bibibi0201/FinalProject/Report/รูปอุปกรณ์/esp32.jpg

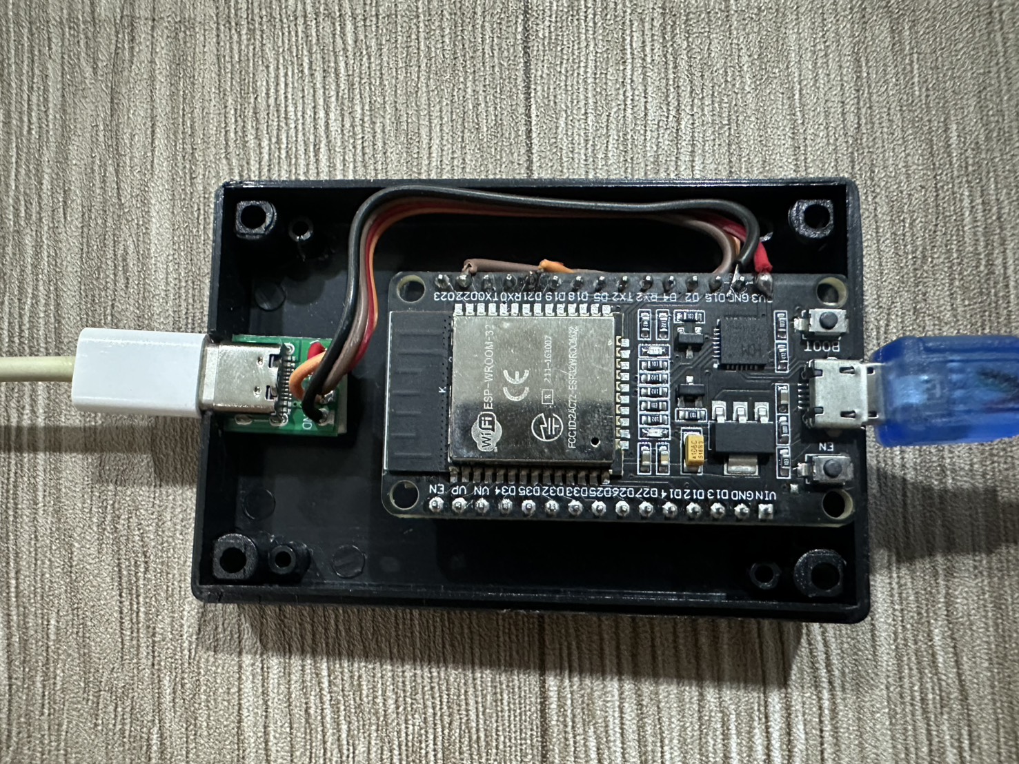
Report/รูปอุปกรณ์/esp32.jpg
