bibibi0201/FinalProject/Report/รูปอุปกรณ์/mpu6050.jpg

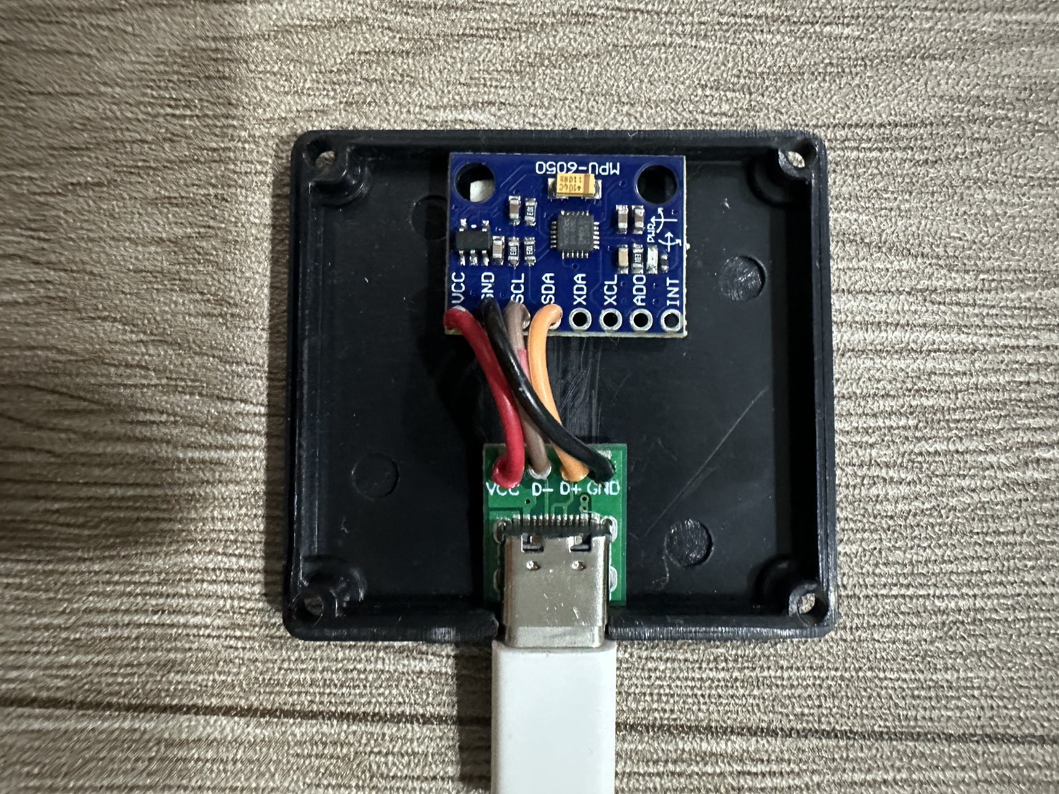
Report/รูปอุปกรณ์/mpu6050.jpg
