bibibi0201/FinalProject/Report/CDIO/แบบรายงานทางเทคนิค_CDIO_ESE-SS-68-02.pdf

## ต้นแบบระบบแจ้งเตือนท่านั่งที่ผิดปกติสําหรับผู้ทํางานออฟฟิศ

A Prototype of an Abnormal Posture Alert System for Office Workers

นางสาวชยาภรณ์ ลิ้มทัศไนยกุล | รหัสนิสิต 65050089
นางสาวกชามาส ขันทะศิลา | รหัสนิสิต 65050096
นายสุทธิอัต | เบ็ญเจิด | รหัสนิสิต 65050247

รายงานสรุปโครงงานฉบับนี้เป็นส่วนหนึ่งของการศึกษาตามหลักสูตรวิศวกรรมศาสตร์บัณฑิต สาขาวิชาวิศวกรรมระบบสมองกลฝังตัวและอิเล็กทรอนิกส์สื่อสาร ภาควิชาวิศวกรรมไฟฟ้า คณะวิศวกรรมศาสตร์ มหาวิทยาลัยบูรพา
ปีการศึกษา 2568

A Prototype of an Abnormal Posture Alert System for Office Workers

Chayaphorn Limtassanaiyakul | Student ID 65050089
Kachamas | Khuntasila | Student ID 65050096
Sutthiut | Benjerd | Student ID 65050247

A PROJECT SUMMARYREPORT SUBMITTED IN PARTIAL FULFILLMENT OF THEREQUIREMENTSFOR THE DEGREE OFBACHELOR OF ENGINEERING EMBEDDED SYSTEM AND ELECTRONIC COMMUNICATION ENGINEERING DEPARTMENT OF ELECTRICALENGINEERING BURAPHA UNIVERSITY2025

ชื่อโครงงาน ต้นแบบระบบแจ้งเตือนท่านั่งที่ผิดปกติสําหรับผู้ทํางานออฟฟิศ
โดย | นางสาวชยาภรณ์ลิ้มทัศไนยกุล รหัสนิสิต 65050089
นางสาวกชามาส ขันทะศิลา | รหัสนิสิต 65050096
นายสุทธิอัต เบ็ญเจิด | รหัสนิสิต 65050247
อาจารย์ที่ปรึกษาดร. สมเจต ศุภรังสรรค์
จํานวนหน้า 15 หน้า
ปีการศึกษา 2568

ภาควิชาวิศวกรรมไฟฟ้า คณะวิศวกรรมศาสตร์มหาวิทยาลัยบูรพา อนุมัติรายงานสรุปโครงงานฉบับนี้เป็นส่วนหนึ่งของการศึกษาตามหลักสูตรปริญญาวิศวกรรมศาสตร บัณฑิต สาขาวิชาวิศวกรรมระบบสมองกลฝังตัวและอิเล็กทรอนิกส์สื่อสาร

| อาจารย์ที่ปรึกษา
(ดร. สมเจต ศุภรังสรรค์)
| หัวหน้าภาควิชาวิศวกรรมไฟฟ้า
(ดร.ณัฐพันธ์ถนอมสัตย์)

รายงานทางเทคนิค (Technical Report) ส่วนที่ 1 รายละเอียดโครงงาน
ชื่อโครงงาน ต้นแบบระบบแจ้งเตือนท่านั่งที่ผิดปกติสําหรับผู้ทํางานออฟฟิศ สาขาวิชา วิศวกรรมระบบสมองกลฝังตัวและอิเล็กทรอนิกส์สื่อสาร วิเคราะห์และกําหนดประเด็นปัญหา (C)

### 1. ที่มาและความสําคัญของปัญหา

ในปัจจุบัน พนักงานออฟฟิศและนักศึกษาจํานวนมากต้องนั่งทํางานหน้าคอมพิวเตอร์เป็น เวลานานต่อเนื่องกันหลายชั่วโมงต่อวัน พฤติกรรมดังกล่าวส่งผลให้เกิดท่านั่งที่ไม่เหมาะสมโดยไม่รู้ตัว เช่น การนั่งหลังค่อม การเอียงลําตัวไปด้านใดด้านหนึ่ง หรือการคงท่าเดิมเป็นเวลานาน ซึ่งล้วนเป็น ความเสี่ยงที่ก่อให้เกิดอาการปวดหลัง ปวดคอ ปวดไหล่และภาวะออฟฟิศซินโดรมในระยะยาว แม้จะมีอุปกรณ์ด้านการยศาสตร์(Ergonomics) เช่น เก้าอี้เพื่อสุขภาพ หรืออุปกรณ์รองรับ แผ่นหลัง แต่ผู้ใช้งานยังไม่สามารถประเมินท่านั่งของตนเองได้แบบเรียลไทม์และไม่ทราบว่าเมื่อใด ที่ท่านั่งเริ่มเบี่ยงเบนจากท่าปกติยิ่งไปกว่านั้นท่าทางและสรีระของแต่ละบุคคลมีความแตกต่างกัน ทําให้ไม่สามารถกําหนดค่ามาตรฐานมุมการนั่งแบบเดียวกันสําหรับทุกคนได้การออกแบบระบบ ที่สามารถปรับเทียบค่ามาตรฐานเฉพาะบุคคล (Personal Calibration) จึงมีความสําคัญ เพื ่อให้ การประเมินท่านั่งมีความแม่นยําและเหมาะสมกับผู้ใช้แต่ละราย
จากปัญหาที่กล่าวมาข้างต้น จึงนํามาสู่แนวคิดในการพัฒนาต้นแบบอุปกรณ์สวมใส่บริเวณ แผ่นหลังตรวจจับท่านั่งที่ผิดร่วมกับแอปพลิเคชันแจ้งเตือนท่านั่ง โดยติดตั้งเซนเซอร์ตรวจวัดเชิงมุม บริเวณกระดูกสันส่วนบน (Thoracic Spine) เพื่อวัดการก้ม – เงยและการเอียงของลําตัวส่วนบน จากนั้นนําข้อมูลที ่ได้ไปเปรียบเทียบกับค ่ามาตรฐานเฉพาะบุคคลที ่ได้จากการปรับเทียบเริ ่มต้น หากพบว่าท่านั่งเบี่ยงเบนเกินช่วงที่กําหนด ระบบจะแจ้งเตือนผู้ใช้งานทันทีผ ่านแอปพลิเคชัน ซึ่งช่วยให้สามารถปรับพฤติกรรมการนั่งให้เหมาะสม และลดความเสี่ยงต่อปัญหาสุขภาพในระยะยาว

### 2. กลุ่มผู้ใช้งาน

พนักงานออฟฟิศทั่วไปหรือผู้ที่ต้องนั่งทํางานหน้าคอมพิวเตอร์เป็นเวลานาน

### 3. กระบวนการได้มาซึ่งรายละเอียดและความต้องการทางวิศวกรรม

การกําหนดรายละเอียดและความต้องการของระบบเกิดจากการศึกษาปัญหาทางด้าน การยศาสตร์งานวิจัยที่เกี่ยวข้องกับการตรวจจับท่านั่ง รวมถึงการวิเคราะห์พฤติกรรมของผู้ใช้งาน ที่ต้องนั่งทํางานเป็นเวลานาน จากการศึกษาพบว ่าระบบที ่มีประสิทธิภาพควรสามารถตรวจจับ การก้ม–เงยและการเอียงลําตัวได้แบบต่อเนื่อง และแจ้งเตือนเมื่อท่านั่งเบี่ยงเบนเกินช่วงที่เหมาะสม นอกจากนี้ยังพบว่าท่าทางและสรีระของแต่ละบุคคลมีความแตกต่างกันจึงกําหนดให้ระบบ ต้องมีขั้นตอนการปรับเทียบค่าเริ่มต้น เพื่อกําหนดค่ามาตรฐานเฉพาะบุคคลก่อนเริ่มใช้งาน

2

จากการวิเคราะห์ดังกล่าว จึงสรุปความต้องการทางวิศวกรรมของระบบได้ดังนี้
1. ระบบต้องสามารถวัดมุมการก้ม–เงย (Pitch) และการเอียงซ้าย–ขวา (Roll) ของ ลําตัวส่วนบนได้อย่างต่อเนื่อง
2. ระบบต้องรองรับการปรับเทียบค่าอ้างอิงเฉพาะบุคคล
3. ระบบต้องสามารถแจ้งเตือนแบบเรียลไทม์เมื่อท่านั่งผิดปกติ
4. ระบบต้องสามารถบันทึกข้อมูลเพื่อวิเคราะห์พฤติกรรมย้อนหลังได้ ลักษณะและความมุ่งหมายของการออกแบบ (C)

### 1. วัตถุประสงค์

1. เพื่อพัฒนาต้นแบบอุปกรณ์สวมใส่ติดแผ่นหลังตรวจจับท่านั่งที่ผิดและแอปพลิเคชัน แจ้งเตือนท่านั่งสําหรับผู้ทํางานออฟฟิศ
2. เพื่อสร้างระบบแสดงผลข้อมูลและระบบแจ้งเตือนท่านั่งที่ไม่เหมาะสมแบบเรียลไทม์
3. เพื่อพัฒนาระบบให้คําแนะนําการปรับท่านั่งและท่ายืดที่เหมาะสม
4. เพื่อจัดเก็บข้อมูลพฤติกรรมการนั่งสําหรับการวิเคราะห์ย้อนหลังและปรับปรุง พฤติกรรมในระยะยาว

### 2. ลักษณะเฉพาะที่ได้คิดค้นขึ้นหรือขอบเขตในการออกแบบ

โครงงานนี้พัฒนาต้นแบบอุปกรณ์สวมใส่ติดแผ่นหลังตรวจจับท่านั่งที่ผิด ที่ติดตั้งเซนเซอร์ ตรวจวัดเชิงมุมเพียง 1 จุดบริเวณกระดูกสันหลังส่วนบน เพื่อใช้ประเมินการก้ม–เงย และการเอียงลําตัวด้านข้าง ในท่านั่งทํางาน โดยเลือกตําแหน่งดังกล่าวเพื่อให้สะท้อนการเปลี่ยนแปลง ของท่าทางช่วงอกตอนบนได้อย่างชัดเจน พร้อมทั้งลดความซับซ้อนและต้นทุนของระบบเมื่อเทียบกับ การใช้หลายเซนเซอร์
ระบบออกแบบให้มีขั้นตอน Calibration สําหรับกําหนดค่าท่าปกติของผู้ใช้แต่ละราย และใช้ค่าความเบี่ยงเบนเชิงมุมจากตําแหน่งอ้างอิงเป็นเกณฑ์ในการประเมินความผิดปกติของท่านั่ง ซึ่งช่วยเพิ่มความเหมาะสมกับสรีระที่แตกต่างกันของผู้ใช้งาน การประมวลผลทําแบบเรียลไทม์เมื่อค่ามุมเกินช่วงที่กําหนด ระบบจะส่งสัญญาณแจ้งเตือน ผ่านแอปพลิเคชัน และบันทึกข้อมูลเพื่อใช้วิเคราะห์แนวโน้มพฤติกรรมการนั่งในระยะยาว

### 3. ขอบเขตการออกแบบ

มุ่งเน้นการตรวจจับท่านั่งในบริบทการทํางานกับโต๊ะหรือคอมพิวเตอร์และเป็นต้นแบบเชิง วิศวกรรมเพื่อการศึกษา

3

การออกแบบทางวิศวกรรม (D)

### 1. ลักษณะ โครงสร้าง และความสัมพันธ์เชิงโครงสร้าง–เชิงหน้าที่ของแต่ละส่วน

ระบบต้นแบบอุปกรณ์สวมใส่ติดแผ่นหลังตรวจจับท่านั่งที่ผิดร่วมกับแอปพลิเคชันแจ้งเตือน ท่านั่ง ประกอบด้วย 3 ส่วนหลัก ได้แก่
1. ส่วนฮาร์ดแวร์
2. ส่วนการประมวลผลและสื่อสารข้อมูล
3. ส่วนแอปพลิเคชันและฐานข้อมูล
1.1 ส่วนฮาร์ดแวร์ (Wearable Hardware Subsystem)
1) เซนเซอร์ตรวจวัดการเอียง ระบบใช้เซนเซอร์MPU6050 ซึ่งเป็นอุปกรณ์ประเภท IMU (Inertial Measurement Unit) แบบ 6 แกน ประกอบด้วย Accelerometer 3 แกนและGyroscope 3 แกน โดย Accelerometer ทําหน้าที่วัดค่าความเร่งเชิงเส้น (a!, a", a#) ส่วน Gyroscope ใช้วัด ค่าความเร็วเชิงมุม (g$, g%, g&) เซนเซอร์ดังกล่าวทําหน้าที่เป็นแหล่งข้อมูลหลักของระบบ โดยตรวจวัดการเคลื่อนไหวและการเอียงของลําตัวผู้ใช้งาน และส่งข้อมูลดิบ (Raw Data) ไปยัง หน่วยประมวลผลกลางเพื่อทําการคํานวณหามุม Pitch และ Roll
2) หน่วยประมวลผลกลางเลือกใช้บอร์ดไมโครคอนโทรลเลอร์ESP32 ซึ ่งทําหน้าที ่เป็น ศูนย์กลางของระบบ โดยทําการอ่านข้อมูลจาก MPU6050 ผ่านการสื่อสารแบบ I

2
C จากนั้น
ประมวลผลข้อมูลเพื่อคํานวณมุมเอียงด้วยวิธีComplementary Filter ซึ่งเป็นเทคนิคการรวมข้อมูล จาก Accelerometer และ Gyroscope เพื่อเพิ่มความแม่นยําของค่ามุมที่ได้ระบบจะคํานวณค่า ความแตกต่างเชิงมุม (∆pitch และ ∆roll) เพื่อใช้ประเมินสถานะท่านั่งว่าอยู่ในเกณฑ์ปกติหรือผิดท่า นอกจากนี้ESP32 ยังทําหน้าที่เชื่อมต่ออินเทอร์เน็ต และส่งข้อมูลไปจัดเก็บยังฐานข้อมูล Firebase บนระบบ Cloud
3) วิธีการคํานวณมุมเอียงของลําตัวด้วย Complementary Filter ในการประมวลผลข้อมูล จากเซนเซอร์MPU6050 ระบบทําการคํานวณมุมเอียงของลําตัวในรูปแบบ Pitch และ Roll โดยใช้ข้อมูลจาก Accelerometer และ Gyroscope ร่วมกัน ผ่านเทคนิค Complementary Filter โดยการคํานวณมุม Pitch และ Roll จาก Accelerometer สามารถเขียนได้ดังสมการที่ (1) และ (2)
accPitch=tan⁻¹ ( ax
!a²

y+a²
z

) ×

180
π

(1)
accRoll =tan⁻¹ ( ay
!a²

x+a²
z

) ×

180
π

(2)

4

โดยที่
ax, ay, az คือค่าความเร่งในแต่ละแกนจาก Accelerometer
ในส่วนของ Gyroscope ระบบจะคํานวณมุมโดยอาศัยการอินทิเกรตค ่าความเร็วเชิงมุม ตามเวลา ดังสมการที่ (3) และ (4)
pitchgyro=old_pitch+ g
x
131

×dt (3)
rollgyro =old_roll+

g
y
131

×dt (4)
โดยที่
g

x, g
y,

คือ ค่าความเร็วเชิงมุม เป็นค่าดิบซึ่งต้องทําการแปลงให้อยู่ในหน่วยองศาต่อวินาที (°/s) โดยใช้ตัวคูณปรับสเกล (Scale Factor) เท่ากับ 131 ซึ่งเป็นค่ามาตรฐานของเซนเซอร์ MPU6050 ในช่วงการวัด ±250 °/s
old_pitch คือ ค่ามุม Pitch จากรอบก่อนหน้า
old_roll คือ ค่ามุม Roll จากรอบก่อนหน้า
dt คือช่วงเวลาระหว่างการวัด
คํานวณ Pitch โดยนําค่าจากสมการที่ (1) และ (3) มารวมกันด้วย Complementary Filter ดังสมการที่ (5) และ (6)
Pitch=0.98 !old_pitch+( g
x
131

)×dt" +0.02 ×accPitch (5)
และคํานวณ Roll โดยนําค่าจากสมการที่ (2) และ (4) มารวมกันด้วย Complementary Filter ดังสมการ
Roll =0.98 !old_roll+(

g
y
131

)×dt" +0.02 ×accRoll (6)
กําหนดค่านํ้าหนัก (Weight) ให้กับข้อมูลจาก Gyroscope เท่ากับ 0.98 และ Accelerometer เท่ากับ 0.02 ซึ่งเป็นการผสมผสานข้อดีของเซนเซอร์ทั้งสองประเภท กล ่าวคือ Gyroscope ให้ค่าที่มีความต่อเนื่องแต่มีแนวโน้มเกิด Drift ในระยะยาว ในขณะที่ Accelerometer ให้ค่าที่มีความเสถียรในระยะยาวแต่มีสัญญาณรบกวนสูง ดังนั้นการรวมข้อมูลด้วยเทคนิค Complementary Filter จึงช่วยให้ได้ค่ามุมเอียงที่มีความแม่นยําและเหมาะสมสําหรับการใช้งาน แบบเรียลไทม์
4) อุปกรณ์แจ้งเตือน (Buzzer Module) ระบบมีการติดตั้งอุปกรณ์แจ้งเตือนประเภท Active Buzzer Module เพื ่อใช้ในการแจ้งเตือนผู้ใช้งานแบบเรียลไทม์เมื ่อมีพฤติกรรมการนั ่งที ่ผิด โดย Buzzer จะทําหน้าที่แปลงสัญญาณไฟฟ้าจากไมโครคอนโทรลเลอร์ให้เป็นสัญญาณเสียง Active Buzzer เป็นอุปกรณ์ที่มีวงจรกําเนิดเสียงภายในตัว (Built-in Oscillator) จึงสามารถ

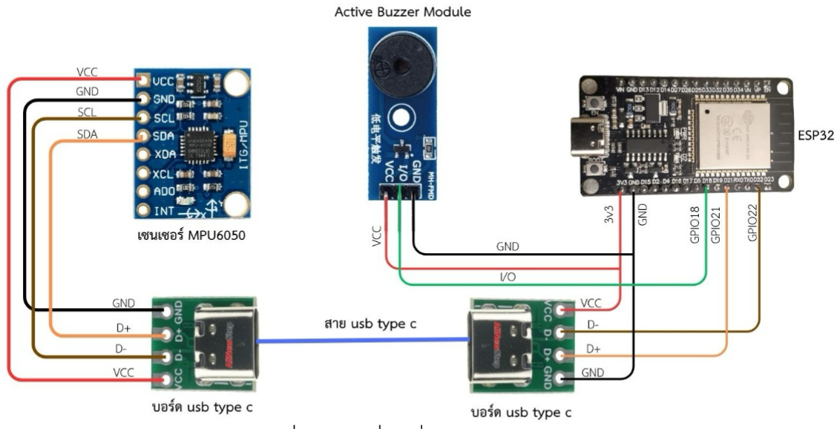
[picture p3: figure]

5

สร้างเสียงได้ทันทีเมื่อได้รับสัญญาณไฟฟ้าแบบดิจิทัล (HIGH/LOW) จากบอร์ด ESP32 โดยไม่จําเป็นต้องสร้างสัญญาณความถี่เพิ่มเติมจากซอฟต์แวร์ ทําให้เหมาะสมกับระบบฝังตัว (Embedded System) ที่ต้องการความเรียบง่ายและตอบสนองรวดเร็ว ในระบบนี้Buzzer ถูกควบคุมผ่านขา GPIO18 ของ ESP32 ซึ่งทําหน้าที่เป็นขา Output เมื่อระบบตรวจพบว่าผู้ใช้งาน มีท่านั่งผิดติดต่อกันตามเงื่อนไขที่กําหนด (เช่น ตรวจพบสถานะ incorrect posture ติดต ่อกัน 3 ครั้ง) ESP32 จะสั่งให้Buzzer ทํางานเพื่อส่งสัญญาณเสียงแจ้งเตือนทันที
5) การออกแบบการเชื่อมต่อวงจร ระบบทําการเชื่อมต่อเซนเซอร์MPU6050 เข้ากับบอร์ด ESP32 ผ่านบอร์ด USB Type-C ซึ่งทําหน้าที่เป็นตัวกลางในการรวมและจัดระเบียบสายสัญญาณ เพื่อให้สามารถถอดประกอบอุปกรณ์ได้สะดวก

รูปที่ 1 การเชื่อมต่อวงจร

### 1. การเชื่อมต่อ MPU6050 กับ บอร์ด USB Type-C

- VCC ต่อกับ VCC (3.3V)
- GND ต่อกับ GND
- SDA ต่อกับขา D+ ของบอร์ด USB Type-C
- SCL ต่อกับขา D− ของบอร์ด Type-C board

### 2. การเชื่อมต่อ ESP32 กับ บอร์ด USB Type-C

- GPIO21 (SDA) ต่อกับขา D+ ของบอร์ด USB Type-C
- GPIO22 (SCL) ต่อกับขา D− ของบอร์ด USB Type-C
- 3V3 ต่อกับ VCC
- GND ต่อกับ GND

6

### 3. การเชื่อมต่อ ESP32 กับ Active Buzzer Module

- GPIO18 ต่อกับขา I/O ของ Buzzer
- 3V3 ต่อกับ VCC
- GND ต่อกับ GND
ในโครงงานนี้ขา D+ และ D− ของบอร์ด USB Type ถูกใช้เป็นเพียงสายสัญญาณสําหรับ I2C communication เท่านั้น ไม่ได้ใช้สําหรับการสื่อสาร USB protocol และสาย USB Type-C ถูกใช้เพื่อรวมสาย VCC, GND, SDA และ SCL ให้อยู่ในสายเดียว เพื่อความสะดวกในการถอด ประกอบและความเรียบร้อยของอุปกรณ์สวมใส่
6) โครงสร้างทางกายภาพของอุปกรณ์สวมใส่ติดแผ่นหลังตรวจจับท่านั่งที่ผิด เซนเซอร์ จะติดตั้งบนสายรัด โดยตําแหน ่งติดตั้งเซนเซอร์จะอยู ่ที่บริเวณกระดูกสันหลังส่วนบน และยึดติด ด้วยกล่องพลาสติกขนาดเล็ก โดยจะวางในแนวระนาบขนานกับพื้นผิวหลัง ดังรูปที่ 2

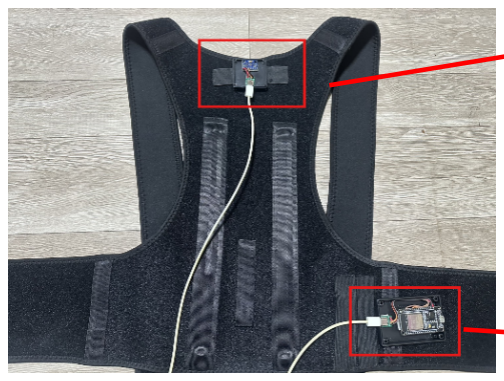
[picture p4: figure]

รูปที่ 2 เซนเซอร์ที่ติดกับตัวอุปกรณ์

### 2. การทํางานของระบบ

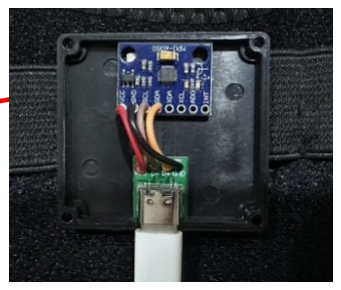
[picture p5: figure]
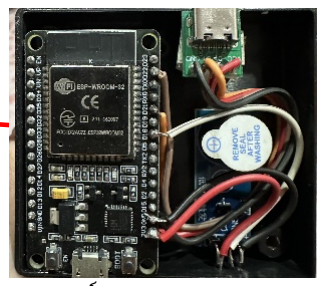
[picture p6: figure]

ภาพรวมการทํางานของระบบอุปกรณ์สวมใส่ติดแผ่นหลังตรวจจับท่านั่งที่ผิดร ่วมกับ แอปพลิเคชันแจ้งเตือนท่านั่ง ซึ่งเป็นระบบตรวจวัดและแจ้งเตือนแบบเชื่อมต่อ Cloud โดยเริ่มต้นจาก ผู้ใช้งาน (User) สวมใส่อุปกรณ์สายรัดที่ประกอบด้วย ESP32 และ MPU6050 ทําหน้าที ่ตรวจวัด ค่าความเอียงของลําตัวขณะนั่ง

(ก) ติดตั้งเซนเซอร์กับสายรัด

(ข) MPU6050

(ค) บอร์ด ESP32 + Buzzer

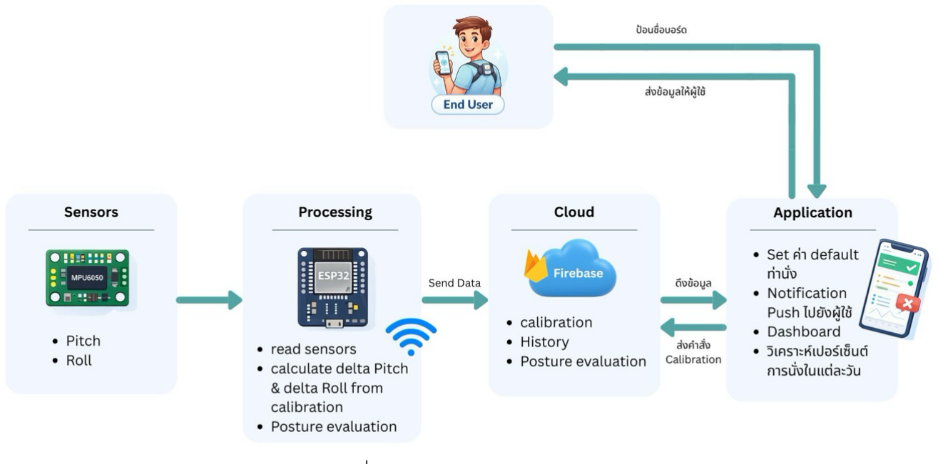
[picture p7: figure]

7

ข้อมูลที่ได้จากเซนเซอร์จะถูกประมวลผลบน ESP32 เพื ่อคํานวณมุมเอียงของลําตัว ในรูปแบบ Pitch และ Roll จากนั้นนําค่าไปเปรียบเทียบกับค่าท่าอ้างอิง (Calibration) เพื่อคํานวณ ค่าความแตกต่าง (Delta) และกําหนดสถานะท ่านั ่งว ่าอยู ่ในเกณฑ์ปกติหรือไม่ ค่าที่คํานวณแล้ว จะถูกส่งผ่านระบบอินเทอร์เน็ตไปจัดเก็บใน Firebase Realtime Database เพื่อบันทึกเป็นข้อมูล ประวัติและใช้เป็นแหล่งข้อมูลสําหรับแอปพลิเคชัน
ทางด้านแอปพลิเคชันที่พัฒนาด้วย Flutter จะดึงข้อมูลจากฐานข้อมูลแบบเรียลไทม์ เพื่อตรวจสอบสถานะท่านั่ง หากตรวจพบว่าค่าความเอียงเกินช่วงที่กําหนด ระบบจะแจ้งเตือน ผู้ใช้งานผ ่านการแจ้งเตือนบนโทรศัพท์มือถือ นอกจากนี้ผู้ใช้ยังสามารถตั้งค ่าท ่านั ่งอ้างอิง ผ่านแอปพลิเคชัน ซึ ่งข้อมูลดังกล ่าวจะถูกบันทึกกลับไปยังฐานข้อมูลและนําไปใช้ในการประเมิน ครั้งถัดไป
ดังนั้น ภาพรวมของระบบจึงเป็นกระบวนการทํางานแบบต่อเนื่อง ตั้งแต ่การตรวจวัด การประมวลผล การจัดเก็บข้อมูลบน Cloud การแจ้งเตือน จนถึงการปรับพฤติกรรมของผู้ใช้งาน ทําให้สามารถติดตามและแก้ไขพฤติกรรมการนั่งได้อย่างเป็นระบบ

รูปที่ 3 ภาพรวมของระบบ
2.1 การปรับเทียบค่าเริ่มต้น (Calibration) ระบบกําหนดให้ผู้ใช้ตั้งท่านั่งที่ถูกต้อง ก่อนเริ่มใช้งาน บันทึกค่า pitch0 และ roll0
จากนั้นคํานวณ:
∆pitch = pitch − pitch0 | (7)
∆roll = roll − roll0 | (8)

8

โดย ∆pitch: ค่าที่บอกว่า ตอนนี้ผู้ใช้งานก้ม/เงยจากท่าปกติไปกี่องศา pitch: มุมการก้ม–เงยของลําตัว ขณะนั้น (ค่าที่เซนเซอร์วัดได้ปัจจุบัน) pitch0: มุมอ้างอิงท่านั่งที่ถูกต้อง
∆roll: ค่าที่บอกว่า ตอนนี้ผู้ใช้งานเอียงซ้าย–ขวาจากท่าปกติไปกี่องศา
roll: มุมการเอียงซ้าย–ขวาของลําตัว ขณะนั้น (ค่าที่เซนเซอร์วัดได้ปัจจุบัน)
roll0: มุมอ้างอิงท่านั่งที่ถูกต้อง แนวคิดนี้ทําให้ระบบรองรับความแตกต่างของสรีระและลักษณะท่านั่งเริ่มต้นของผู้ใช้งาน แต่ละบุคคลได้อย่างเหมาะสม
2.2 เกณฑ์การประเมินท่านั่ง หลังจากคํานวณค่าความเบี่ยงเบนเชิงมุมตามสมการ (7) และ
(8) แล้ว ระบบจะทําการประเมินสถานะท่านั่งโดยกําหนดช่วง ดังนี้
−20° ≤ ∆pitch ≤ 20° | (9)
−10° ≤ ∆roll ≤ 10° | (10)
หลักการตัดสินใจของระบบ
1) หากค่า ∆pitch และ ∆roll อยู่ภายในช่วงที่กําหนดตามสมการ (9) และ (10) พร้อมกัน ระบบกําหนดสถานะท่านั่งเป็น Posture = “correct”
2) หากค่าใดค่าหนึ่งเกินช่วงที่กําหนด คือ |∆pitch| > 20° หรือ |∆roll| > 10° ระบบกําหนดสถานะท่านั่งเป็น Posture = “incorrect”

### 3. ส่วนการสื่อสารและฐานข้อมูล

ESP32 เชื่อมต่ออินเทอร์เน็ตผ่าน Wi–Fi และส่งค่ามุมเอียง pitch และ roll ไปเก็บไว้ใน Firebase Realtime Database แบบเรียลไทม์ข้อมูลจะถูกจัดเก็บแยกตามชื่อบอร์ด (เช่น esp01) และแบ่งเป็น 2 ส่วนหลัก ได้แก่
1. calibration เก็บค่าอ้างอิงเริ่มต้น (pitch0, roll0) สําหรับใช้เปรียบเทียบท่าทางการนั่ง
2. history เก็บข้อมูลท่าทางการนั่งย้อนหลัง โดยแยกตามวันและเวลา ภายในจะมีค่า pitch, roll, deltaPitch, deltaRoll และสถานะท่านั่ง (correct / incorrect) และท ่านั ่งที ่ผู้ใช้นั ่งผิด เช่น ก้มมากไป เงยมากไป เอียงซ้าย-ขวามากไป โดยจะเก็บข้อมูลการนั่งทุก 15 วินาที โครงสร้างนี้ช่วยให้แอปพลิเคชันสามารถดึงข้อมูลย้อนหลังไปวิเคราะห์และสรุปพฤติกรรม การนั่งของผู้ใช้ในแต่ละวันได้อย่างเป็นระบบ

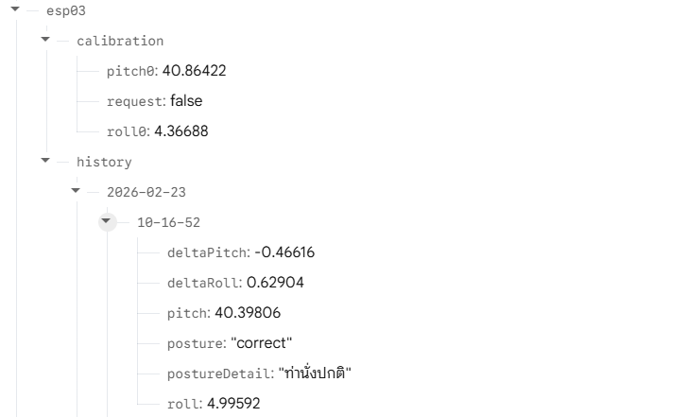
[picture p8: figure]

9

รูปที่ 4 การเชื่อมต่อกับฐานข้อมูล

### 4. ส่วนแอปพลิเคชัน

แอปพลิเคชันถูกพัฒนาด้วย Flutter ทําหน้าที่เป็นส่วนติดต่อผู้ใช้ (User Interface) สําหรับแสดงผลข้อมูลและแจ้งเตือนสถานะท่านั่งของผู้ใช้งานแบบเรียลไทม์โดยเชื ่อมต ่อกับ Firebase Realtime Database เพื่อดึงข้อมูลมุมเอียงของลําตัว (Pitch และ Roll) รวมถึงสถานะ ท่านั่ง (Posture) ที ่ถูกประมวลผลจากอุปกรณ์แอปพลิเคชันสามารถแสดงข้อมูลปัจจุบัน (Dashboard) คือ ค่ามุม Pitch และ Roll สถานะท่านั่ง และรายละเอียดของท ่าทางที ่ผิด (postureDetail) เพื่อให้ผู้ใช้งานสามารถรับรู้และเข้าใจลักษณะการนั่งของตนเองได้ นอกจากนี้ยังมีส่วนแสดงผลข้อมูลย้อนหลัง (History) ซึ ่งทําการสรุปผลพฤติกรรมการนั่ง ในแต่ละวันในรูปแบบเปอร์เซ็นต์ของท่านั่งที่ถูกต้องและไม่ถูกต้อง เพื่อใช้ในการวิเคราะห์และปรับปรุง พฤติกรรม
ในส่วนของการแจ้งเตือน ระบบกําหนดเงื่อนไขเพื่อเพิ่มความแม่นยําในการแจ้งเตือน โดยจะทําการแจ้งเตือนเมื่อผู้ใช้งานอยู่ในสถานะท่านั่งที่ไม่ถูกต้อง (incorrect) ติดต ่อกัน จํานวน 3 ครั้งขึ้นไป ซึ ่งเป็นการช ่วยลดการแจ้งเตือนที ่เกิดจากความคลาดเคลื ่อนของข้อมูล เมื่อเงื่อนไขดังกล่าวเป็นจริง แอปพลิเคชันจะแสดงการแจ้งเตือนบนอุปกรณ์มือถือทันทีเพื่อกระตุ้น ให้ผู้ใช้งานปรับเปลี่ยนท่านั่งให้ถูกต้อง
นอกจากนี้แอปพลิเคชันยังรองรับการตั้งค่าการใช้งาน คือ การสั ่งปรับเทียบค ่าเริ ่มต้น (Calibration) ผ่านแอปพลิเคชัน ซึ่งช่วยให้ระบบสามารถปรับให้เหมาะสมกับผู้ใช้งานแต่ละคนได้ อย่างมีประสิทธิภาพ

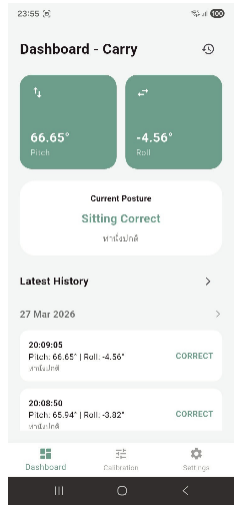
[picture p9: figure]

10

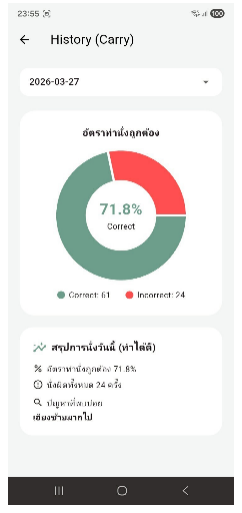
[picture p10: figure]
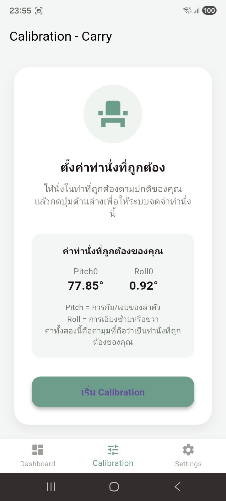
[picture p11: figure]

รูปที่ 5 หน้าแอปพลิเคชัน

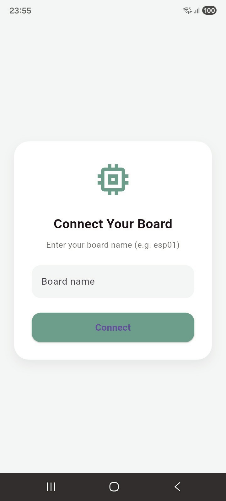
[picture p12: figure]

การทดสอบในห้องปฏิบัติการ (I)

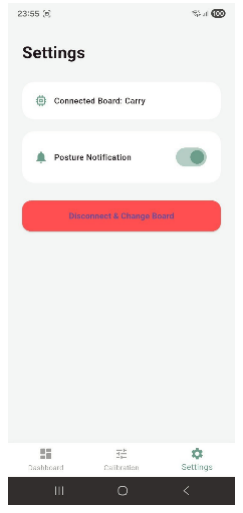
[picture p13: figure]

ก่อนเริ่มการทดสอบ ระบบได้ทําการตั้งค่า Calibration เพื่อกําหนดค่ามุมอ้างอิงของผู้ใช้งาน ในท่านั่งที่ถูกต้อง
1. การทดสอบการจําแนกและรายละเอียดท่าทาง (Posture Classification & Detail Test) การทดสอบนี้มีวัตถุประสงค์เพื่อตรวจสอบความสามารถของระบบในการจําแนกท่าทางการนั่งว่า “ถูกต้อง (correct)” หรือ “ไม่ถูกต้อง (incorrect)” พร้อมทั้งระบุรายละเอียดของท่าทาง (postureDetail) โดยอ้างอิงค่ามุม deltaPitch และ deltaRoll
ตารางที่1 การทดสอบการจําแนกและรายละเอียดท่าทาง
เริ่มต้นท่านั่งที่ถูกต้อง pitch0 = 51.72 และ roll0 = -0.50 ค่าดังกล่าวจะใช้เป็นค่าเริ่มต้น ในการคํานวณความแตกต่างของมุม (delta ) ดังสมการที่ (7) และ (8)
ท่าทาง | deltaPitch | deltaRoll | ผลลัพธ์ที่คาดหวัง (Classification) | postureDetail ที่คาดหวัง | ผลการ ทดสอบ
นั่งตรง | -1.19 | 0.135 | correct | ท่านั่งถูกต้อง | ถูกต้อง
ก้มหน้า | -28.77 | 6.49 | incorrect | ก้มหน้ามากไป | ถูกต้อง
เอนหลัง | 29.03 | 0.12 | incorrect | เงยหน้ามากไป | ถูกต้อง
เอียงซ้าย | -16.17 | -10.31 | incorrect | เอียงซ้ายมากไป | ถูกต้อง
เอียงขวา | 2.53 | 18.93 | incorrect | เอียงขวามากไป | ถูกต้อง

(ก) หน้าเชื่อมต่อ

(ข) หน้า Calibration (ค) หน้า Dashboard (ง) หน้า History (จ) หน้า Settings

11

จากตารางที่ 1 ระบบสามารถจําแนกท่าทางการนั่งได้ถูกต้องทุกกรณีทั้งท ่านั ่งปกติ และท่าผิดปกติพร้อมทั้งระบุรายละเอียดของท่าผิดปกติ (postureDetail) ได้ตรงตามที ่คาดหวัง เช่น ก้มหน้า, เอนหลัง, เอียงซ้าย และเอียงขวา
ตารางที่2 การทดสอบการจําแนกและรายละเอียดท่าทางกรณีที่ติดตั้งเซนเซอร์สลับด้าน เริ่มต้นท่านั่งที่ถูกต้อง pitch0 = -53.07 และ roll0 = 0.93 ค่าดังกล่าวจะใช้เป็นค่าเริ่มต้น ในการคํานวณความแตกต่างของมุม (delta ) ดังสมการที่ (7) และ (8)
ท่าทาง | deltaPitch | deltaRoll | ผลลัพธ์ที่ คาดหวัง (Classification) | postureDetail ที่คาดหวัง | postureDetail ที่ได้ | ผลการ ทดสอบ
นั่งตรง | 7.52 | -1.08 | correct | ท่านั่งถูกต้อง | ท่านั่งถูกต้อง | ถูกต้อง
ก้มหน้า | 51.85 | -1.22 | incorrect | ก้มหน้ามากไป | เงยหน้ามากไป | ไม่ถูกต้อง
เอนหลัง | -22.64 | 2.99 | incorrect | เงยหน้ามากไป | ก้มหน้ามากไป | ไม่ถูกต้อง
เอียงซ้าย | 7.60 | 12.43 | incorrect | เอียงซ้ายมากไป | เอียงขวา มากไป | ไม่ถูกต้อง
เอียงขวา | 4.58 | -17.76 | incorrect | เอียงขวามากไป | เอียงซ้าย มากไป | ไม่ถูกต้อง

จากการทดสอบระบบในกรณีที่ติดตั้งเซนเซอร์แบบสลับด้าน โดยกําหนดค่าเริ่มต้นของท่านั่ง ที่ถูกต้องเป็น pitch0 = -53.07 และ roll0 = 0.93 พบว่า ระบบสามารถตรวจจับ ท่านั่งตรงได้ถูกต้อง ตรงตามที่คาดหวัง แต่เมื่อทดสอบในท่าทางที่มีการเคลื่อนไหวผิดจากปกติได้แก่ ก้มหน้า, เอนหลัง, เอียงซ้าย และเอียงขวา พบว่าระบบสามารถจําแนกได้เพียงว่าเป็นท่าทางไม่ถูกต้อง (incorrect) เท่านั้น แต่ไม่สามารถระบุรายละเอียดของท่าทางผิดได้อย่างถูกต้อง โดยรายละเอียดท่าทางที่ระบบแสดงผลมีการ กลับด้านจากความเป็นจริง ดังนี้
- ท่าก้มหน้า → ระบบแสดงเป็น เงยหน้ามากไป
- ท่าเอนหลัง → ระบบแสดงเป็น ก้มหน้ามากไป
- ท่าเอียงซ้าย → ระบบแสดงเป็น เอียงขวามากไป
- ท่าเอียงขวา → ระบบแสดงเป็น เอียงซ้ายมากไป
2. การทดสอบระบบแจ้งเตือน (Notification Test) การทดสอบนี้มีวัตถ ุประสงค์ เพื่อตรวจสอบระบบแจ้งเตือนผู้ใช้งาน ทํางานได้ตามเงื่อนไขที่กําหนดโดยเงื่อนไขคือ แจ้งเตือน เมื่อผู้ใช้งานอยู่ในท่าผิดติดต่อกัน ครบ 3 ครั้ง หลังจากแจ้งเตือนแล้วระบบจะนับใหม่ ก่อนแจ้งเตือนครั้งต่อไป เพื่อป้องกันการแจ้งเตือนซํ้าซ้อน

12

ตารางที่3 การทดสอบระบบแจ้งเตือน
ครั้งที่ตรวจพบ incorrect | สถานะที่คาดหวัง | ผลการทดสอบ
1 | ยังไม่แจ้งเตือน | ไม่แจ้งเตือน
2 | ยังไม่แจ้งเตือน | ไม่แจ้งเตือน
3 | แจ้งเตือน | แจ้งเตือน
4 | นับใหม่ (ยังไม่แจ้งเตือน) | ไม่แจ้งเตือน
5 | ยังไม่แจ้งเตือน | ไม่แจ้งเตือน
6 | แจ้งเตือน | แจ้งเตือน
จากตารางที่ 3 ระบบสามารถแจ้งเตือนผู้ใช้งานได้ตามเงื่อนไขที่กําหนด คือแจ้งเตือน เมื่อผู้ใช้งานอยู่ในท่าผิดติดต่อกันครบ 3 ครั้ง และหลังจากแจ้งเตือนแล้ว ระบบจะนับใหม่ ก่อนแจ้งเตือนครั้งต่อไป ทําให้ลดการแจ้งเตือนซํ้าซ้อนและสร้างความเหมาะสมในการเตือนผู้ใช้งาน ตารางที่4 การทดสอบระบบแจ้งเตือนจาก Active Buzzer
ครั้งที่ตรวจพบ incorrect | สถานะที่คาดหวัง | ผลการทดสอบ
1 | ยังไม่แจ้งเตือน | ไม่แจ้งเตือน
2 | ยังไม่แจ้งเตือน | ไม่แจ้งเตือน
3 | แจ้งเตือน | แจ้งเตือน
4 | นับใหม่ (ยังไม่แจ้งเตือน) | ไม่แจ้งเตือน
5 | ยังไม่แจ้งเตือน | ไม่แจ้งเตือน
6 | แจ้งเตือน | แจ้งเตือน
จากตารางที่ 4 พบว่า ระบบแจ้งเตือนด้วย Active Buzzer สามารถทํางานได้สอดคล้อง กับเงื่อนไขที่กําหนดเช่นเดียวกับระบบแอปพลิเคชัน โดย Buzzer จะส่งสัญญาณเสียง เมื่อมีการตรวจพบท่านั่งผิดติดต่อกันครบ 3 ครั้ง และจะหยุดการแจ้งเตือนพร้อมรีเซ็ตตัวนับหลังจาก มีการแจ้งเตือนในแต่ละครั้ง การแจ้งเตือนในรูปแบบเสียงนี้ช่วยให้ผู้ใช้งานสามารถรับรู้สถานะ ของตนเองได้ทันทีโดยไม่จําเป็นต้องมองหน้าจอ ส่งผลให้ระบบมีความเหมาะสมต่อการใช้งานจริง ในลักษณะอุปกรณ์สวมใส่ (Wearable Device) และเพิ่มประสิทธิภาพของการแจ้งเตือน แบบเรียลไทม์

13

ผลการทดสอบการใช้งานจริง (O)
วิธีการประเมินผล
การทดสอบการใช้จริงครั้งนี้เก็บข้อมูลจากกลุ่มตัวอย่างจํานวน 25 คน โดยให้ผู้เข้าร่วม ทดลองใช้งานระบบตรวจจับท่าทางการนั่ง และทําการประเมินผลก่อนและหลังการใช้งาน (Pre-Post Test)
นอกจากนี้ได้ทําการวิเคราะห์ข้อมูลโดยใช้สถิติPaired t-test เพื่อเปรียบเทียบ ความแตกต่างของค่าเฉลี่ยก่อนและหลังการใช้งาน
ตารางที่5 สรุปผลการประเมินทั้ง 3 ด้าน

จากตารางที่ 5 ผลการประเมินทั้ง 3 ด้าน พบว่าโครงงานมีค่ามัธยฐานอยู่ในระดับ “ดี” ถึง “ดีเยี่ยม” ในทุกด้าน โดยด้านแอปพลิเคชันและด้านประโยชน์ต่อสุขภาพได้รับการประเมินในระดับ “ดีเยี่ยม” แสดงให้เห็นว่าระบบสามารถใช้งานได้จริงและมีศักยภาพในการช่วยปรับปรุงพฤติกรรม การนั่งของผู้ใช้งาน ในขณะที่ด้านอุปกรณ์ฮาร์ดแวร์อยู่ในระดับ “ดี” ซึ่งสามารถพัฒนาเพิ่มเติมในด้าน ความสะดวกและรูปแบบการใช้งานให้ดียิ่งขึ้น
ตารางที่6 ผลการทดสอบเปรียบเทียบก่อนและหลังการใช้งาน (Pre-Post Test)
ตัวแปร | ค่าเฉลี่ยก่อน (Pre) | ค่าเฉลี่ยหลัง (Post) | t-value | p-value
ระดับความปวด (Pain) | 1.88 | 1.52 | 2.3772 | 0.0258
การรับรู้ท่าทาง (Awareness) | 1.28 | 2.68 | -9.8995 | p < 0.001
หัวข้อประเมิน | ค่ามัธยฐาน | ระดับ
อุปกรณ์ฮาร์ดแวร์(Hardware & Sensor) | 4 | ดี
แอปพลิเคชันและการแสดงผล (Software & User Interface) | 5 | ดีเยี่ยม
ประโยชน์ต่อสุขภาพและการนําไปใช้งานจริง (Health Impact & Practicality) | 5 | ดีเยี่ยม

14

จากตารางที่ 6 ผลการทดสอบแบบ Paired t-test พบว่า ระดับความปวด (Pain) ก่อนและหลังการใช้งานมีความแตกต่างกันอย่างมีนัยสําคัญทางสถิติ (t = 2.3772, p = 0.0258) โดยพบว่าค่าเฉลี่ยหลังการใช้งานลดลง แสดงว่าระบบสามารถช่วยลดระดับความปวดของผู้ใช้งาน ได้ในระดับหนึ่ง ในขณะที่การรับรู้ท่าทาง (Awareness) หลังการใช้งานมีค่าเฉลี่ยสูงขึ้นอย่างชัดเจน และมีความแตกต่างอย่างมีนัยสําคัญทางสถิติ (t = -9.8995, p < 0.001) แสดงว่าระบบสามารถ ช่วยเพิ่มการรับรู้เกี่ยวกับท่าทางของผู้ใช้งานได้ดังนั้นสามารถสรุปได้ว่าระบบมีผลต่อทั้งการลดระดับ ความปวด และการเพิ่มการรับรู้ท่าทางของผู้ใช้งานอย่างมีนัยสําคัญทางสถิติ และจากข้อเสนอแนะของผู้ใช้งาน พบว่าสามารถพัฒนาเพิ่มเติมได้เช่น การออกแบบ อุปกรณ์ให้สวมใส่ง่ายและเหมาะสมกับผู้ใช้หลากหลายกลุ่ม การลดความเกะกะของสายไฟโดยพัฒนา เป็นระบบไร้สาย และการปรับปรุงคําแนะนําในแอปพลิเคชันให้มีความชัดเจนและเหมาะสมมากยิ่งขึ้น ส่วนที่ 2 บทสรุปการออกแบบ
บทสรุปการออกแบบ
โครงงานนี้มุ่งพัฒนาและออกแบบระบบตรวจวัดและประเมินท่าทางการนั่งแบบเรียลไทม์ โดยบูรณาการเซนเซอร์ตรวจจับการเคลื่อนไหวร่วมกับไมโครคอนโทรลเลอร์เพื่อประมวลผล ค่ามุม Pitch และ Roll และส่งข้อมูลไปยังแอปพลิเคชันผ่านเครือข่ายอินเทอร์เน็ต โดยมีการปรับปรุง ด้านความแม่นยําด้วยระบบ Calibration และออกแบบส่วนติดต่อผู้ใช้ให้เข้าใจง่าย เพื่อเพิ่มประสบการณ์การใช้งาน ทั้งนี้ระบบสามารถต่อยอดเชิงพาณิชย์ในกลุ่มเทคโนโลยีสุขภาพ โดยตอบโจทย์ผู้ใช้งานที ่ต้องการดูแลบุคลิกภาพและลดความเสี ่ยงด้านสุขภาพจากการนั ่งผิดท่า พร้อมสร้างโอกาสในการพัฒนาเป็นผลิตภัณฑ์และบริการที่มีมูลค่าเพิ่มในอนาคต

15

ส่วนที่ 3 บรรณานุกรม
กระดูกสันหลัง. (8 พฤศจิกายน 2567). ใน วิกิพีเดีย. https://th.wikipedia.org/wiki/กระดูกสันหลัง คณะทํางานจัดทํามาตรฐานการประเมินความเสี่ยงด้านการยศาสตร์. (2564). มาตรฐานการประเมิน ความเสี่ยงด้านการยศาสตร์ของท่าทางการปฏิบัติงานในลักษณะสถิต (สสปท. 1-4-05-02-00-2564). สถาบันส่งเสริมความปลอดภัย อาชีวอนามัย และสภาพแวดล้อมในการทํางาน. จันทณีนิลเลิศ. (2560). การนั่งตามหลักการยศาสตร์. เวชบันทึกศิริราช, 10(1), 23–28. ศูนย์กายภาพบําบัด คณะกายภาพบําบัด มหาวิทยาลัยมหิดล. (2566). ปวดหลังส่วนบน…อาการปวด ที่ไม่ควรมองข้าม ตอนที่ 1. https://pt.mahidol.ac.th/ptcenter/knowledge-article/thoracic_pain_ep-1/
ศูนย์กายภาพบําบัด คณะกายภาพบําบัด มหาวิทยาลัยมหิดล. (2562). ออกกําลังกายป้องกันหลัง ค่อม. https://pt.mahidol.ac.th/ptcenter/knowledge-article/ออกกําลังกายป้องกันหลัง/
Bijanzadeh, A., Hermanns, I., Ellegast, R., Fraeulin, L., Holzgreve F., Mache, S., Groneberg, D., Ohlendorf , D. (2020). A kinematic posture analysis of neurological assistants in their daily working practice–a pilot study. Journal of Occupational Medicine and Toxicology, 15(36). https://doi.org/10.1186/s12995-020-00286-9
Burahmune, K., Ishac, K., Amagasa, T.(2022). Intelligent posture training: Machine-learning- powered human sitting posture recognition based on a pressure-sensing IoT cushion. Sensors, 22(14), 5337. https://doi.org/10.3390/s22145337 Tawil, Y. (2023). Basics of Accelerometer and Gyroscope Sensors and How to Compute Pitch, Roll and Yaw Angle. https://atadiat.com/en/e-towards-understanding-imu-basics-of-accelerometer-and-gyroscope-sensors/

( ดร. สมเจต ศุภรังสรรค์)
อาจารย์ที่ปรึกษาโครงงาน

16

## ภาคผนวก

17

แบบสอบถามความพึงพอใจ
คําชี้แจง :
1. แบบสอบถามแบ่งออกเป็น 2 ส่วน คือ
ส่วนที่1 ข้อมูลทั่วไป
ส่วนที่2 ความพึงพอใจและประสิทธิภาพการใช้งาน
ส่วนที่3 ข้อเสนอแนะ
2. แบบสอบถามนี้เป็นส่วนหนึ่งของโครงการต้นแบบระบบแจ้งเตือนท่านั่งที่ผิดปกติสําหรับ ผู้ทํางานออฟฟิศ มีวัตถุประสงค์เพื่อเก็บรวบรวมข้อมูล สําหรับการวิเคราะห์ความพึงพอใจและ ประสิทธิภาพต่อการใช้งานชิ้นงานและแอปพลิเคชัน
3. ข้อมูลของท่านจะถูกนําไปใช้ในโครงการเท่านั้น และข้อมูลของท่านจะถูกเก็บรักษาเป็น ความลับ และเปิดเผยเฉพาะในรูปแบบข้อมูลภาพรวมที่ไม่สามารถระบุตัวตนได้

ตอนที่1 ข้อมูลทั่วไปของผู้ตอบแบบสอบถาม
คําชี้แจง : โปรดทําเครื่องหมาย ü ลงใน o ที่ตรงกับข้อมูลของท่าน
1. เพศ o ชาย o หญิง
2. อายุ o 18 – 29 ปี o 30 – 44 ปี o 45 – 59 ปี o 60 ปีขึ้นไป
3. ส่วนสูง | เซนติเมตร
4. นํ้าหนัก | กิโลกรัม
5. ค่าองศาเริ่มต้นที่วัด Pitch และ Roll ของท่าน ตัวอย่าง p(pitch) = x.xx , r(Roll) = x.xx
5.1 ค่าองศาเริ่มต้นที่วัด Pitch : |
5.2 ค่าองศาเริ่มต้นที่วัด Roll : |
6. โดยปกติคุณนั่งทํางาน/เรียนหน้าคอมพิวเตอร์เฉลี่ยวันละกี่ชั่วโมง
- น้อยกว่า 4 ชั่วโมง o 4 – 8 ชั่วโมง o มากกว่า 8 ชั่วโมง
7. คุณมีอาการปวดหลัง คอ บ่า ไหล่ (Office Syndrome) เป็นประจําหรือไม่
- มี | o เป็นบางครั้งบางคราว | o ไม่มี
8. ท่านยินยอมให้เก็บรวบรวมและใช้ข้อมูลส่วนบุคคลของท่านหรือไม่?
- ยินยอม o ไม่ยินยอม
ตอนที่2 ความพึงพอใจและประสิทธิภาพการใช้งาน
คําชี้แจง : โปรดประเมินผลความพึงพอใจ ใส่เครื่องหมาย ü ในช่องระดับความพึงพอใจ โดยแบ่งเป็น 5 ระดับ ได้แก่ดีเยี่ยม = 5, ดี= 4, ปานกลาง = 3, น้อย = 2, ปรับปรุง = 1

18

ตารางที่1 ด้านอุปกรณ์ฮาร์ดแวร์

ตารางที่2 ด้านแอปพลิเคชันและการแสดงผล

อุปกรณ์ฮาร์ดแวร์ (Hardware & Sensor) | ความพึงพอใจ
ดีเยี่ยม | ดี | ปานกลาง | น้อย | ปรับปรุง
ขนาดและนํ้าหนักของอุปกรณ์มีความกะทัดรัด ไม่เกะกะ

อุปกรณ์สามารถสวมใส่ หรือติดตั้งใช้งานได้ ง่าย ไม่ซับซ้อน

ความรู้สึกสบายเมื่อต้องใช้งานอุปกรณ์ ติดต่อกันเป็นเวลานาน

อุปกรณ์ไม่ก่อให้เกิดความร้อนจนรบกวนการ ใช้งาน

ความทนทานและรูปแบบการจัดเก็บสายไฟ/ ตัวบอร์ด ดูปลอดภัยและเรียบร้อย

แอปพลิเคชันและการแสดงผล (Software & User Interface) | ความพึงพอใจ
ดีเยี่ยม | ดี | ปานกลาง | น้อย | ปรับปรุง
การออกแบบหน้าจอแอปพลิเคชัน (UI) มี ความสวยงาม ทันสมัย

ความรวดเร็วในการคํานวณและแสดงผล คะแนนรวมของการนั่ง

หน้าแสดงประวัติ(History) และการสรุปผล ข้อมูล เข้าใจง่าย ช่วยให้ท่านเห็นแนวโน้ม พฤติกรรมการนั่งของตนเองได้ชัดเจน

ข้อความคําแนะนํา (Advice) มีความเหมาะสม เข้าใจง่าย และน่าสนใจ

ระดับภาษาที่ระบบใช้แจ้งเตือน (ชมเชย, แนะนํา, ตักเตือน) ช่วยสร้างแรงจูงใจได้ดี

19

ตารางที่3 ประโยชน์ต่อสุขภาพและการนําไปใช้งานจริง

ส่วนที่3 ข้อเสนอแนะ
ประโยชน์ต่อสุขภาพและการนําไปใช้งานจริง (Health Impact & Practicality) | ความพึงพอใจ
ดีเยี่ยม | ดี | ปานกลาง | น้อย | ปรับปรุง
ระบบนี้ช่วยให้คุณตระหนักรู้ (Awareness) ถึง ท่านั่งที่ผิดปกติของตนเองได้เร็วขึ้น

ข้อความแจ้งเตือนช่วยกระตุ้นให้คุณอยาก ปรับเปลี่ยนท่านั่งให้ถูกต้อง

หากใช้งานเป็นประจํา คุณเชื่อว่าระบบนี้จะ ช่วยลดอาการปวดหลัง/ออฟฟิศซินโดรมได้

ความเหมาะสมของระบบนี้ในการนําไปใช้จริง ในชีวิตประจําวัน (เวลาทํางาน/เรียน)

ความพึงพอใจในภาพรวม
