bibibi0201/FinalProject/Report/Flowchart/main_flowchart.png

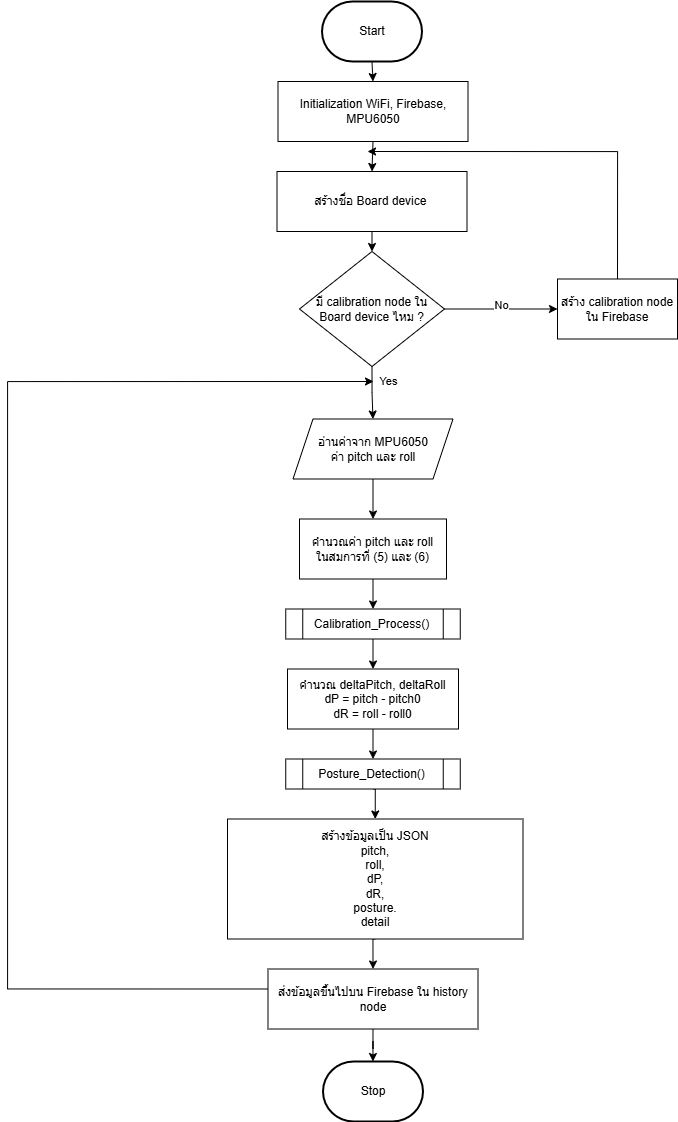
Report/Flowchart/main_flowchart.png
