bibibi0201/FinalProject/Report/Flowchart/Posture_Detection.png

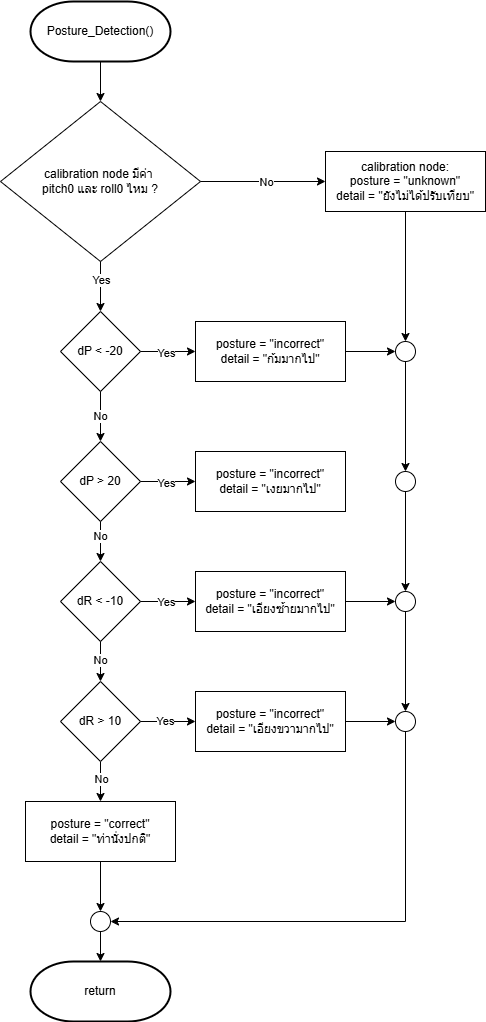
Report/Flowchart/Posture_Detection.png
