bibibi0201/FinalProject/Report/รูปอุปกรณ์/prototype.jpg

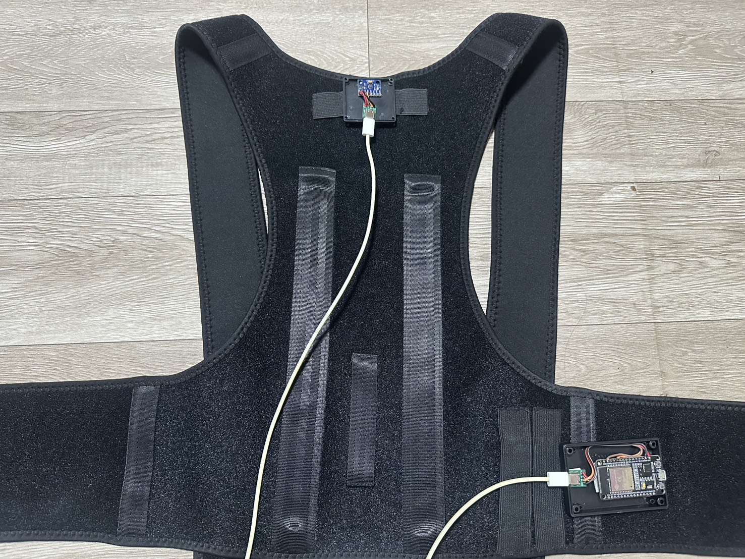
Report/รูปอุปกรณ์/prototype.jpg
