bibibi0201/FinalProject/guidedev/วิธีสร้าง_ProjectFirebase.docx

วิธีสร้างโปรเจคใน Firebase Realtime Database

1. Login Firebase แล้วเข้าไปที่ Firebase console และกด Get started by setting up a Firebase project เพื่อสร้าง project

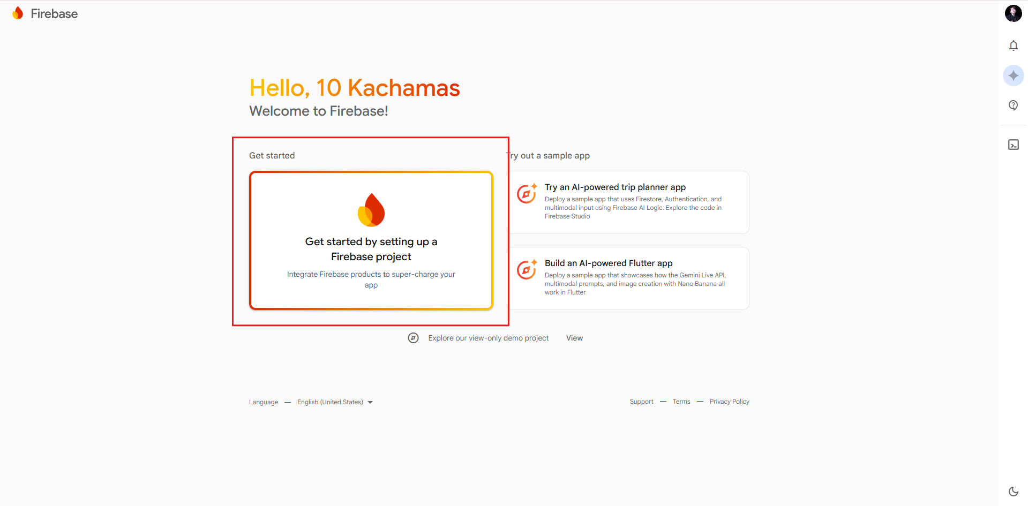
[picture p18: figure]

รูปที่ 1 Login Firebase

2. ตั้งชื่อ Project แล้วกด continue เรื่อย ๆ จนตัวเว็บสร้าง Project ให้

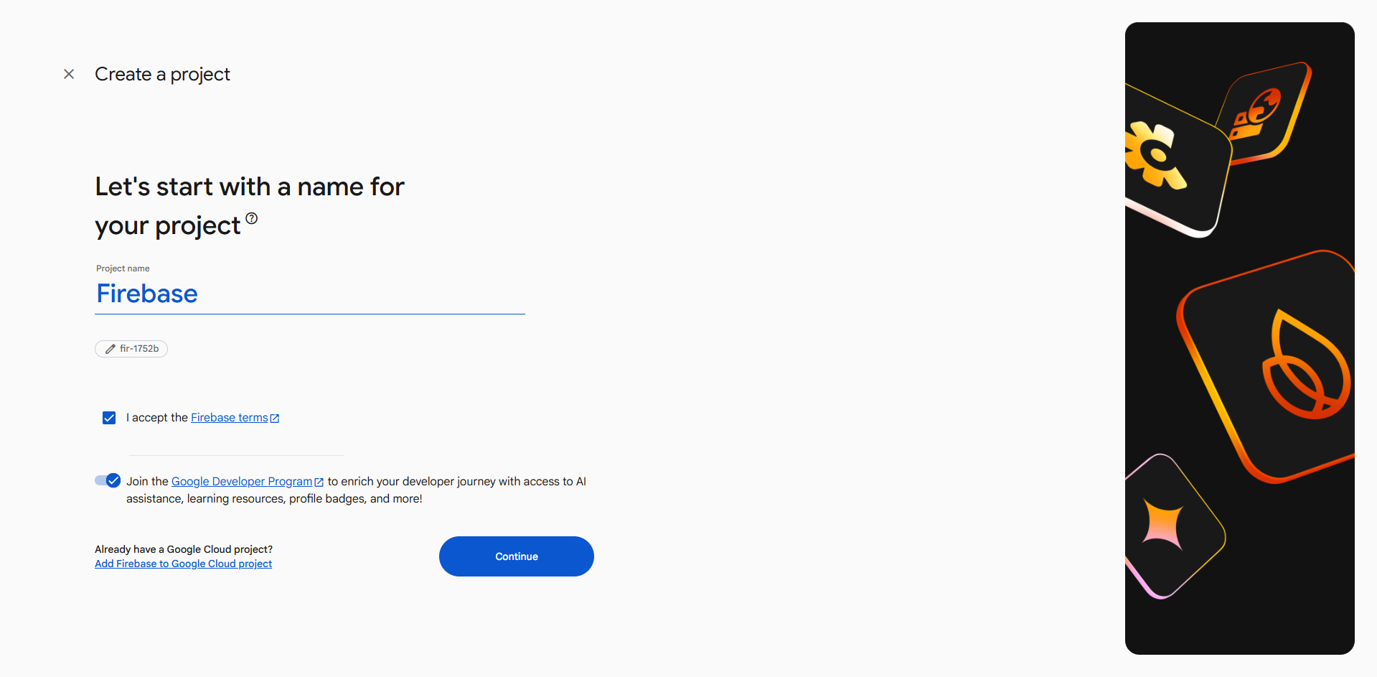
[picture p19: figure]

รูปที่ 2 ตั้งชื่อโปรเจค

3. สร้าง project ใน firebase เสร็จ

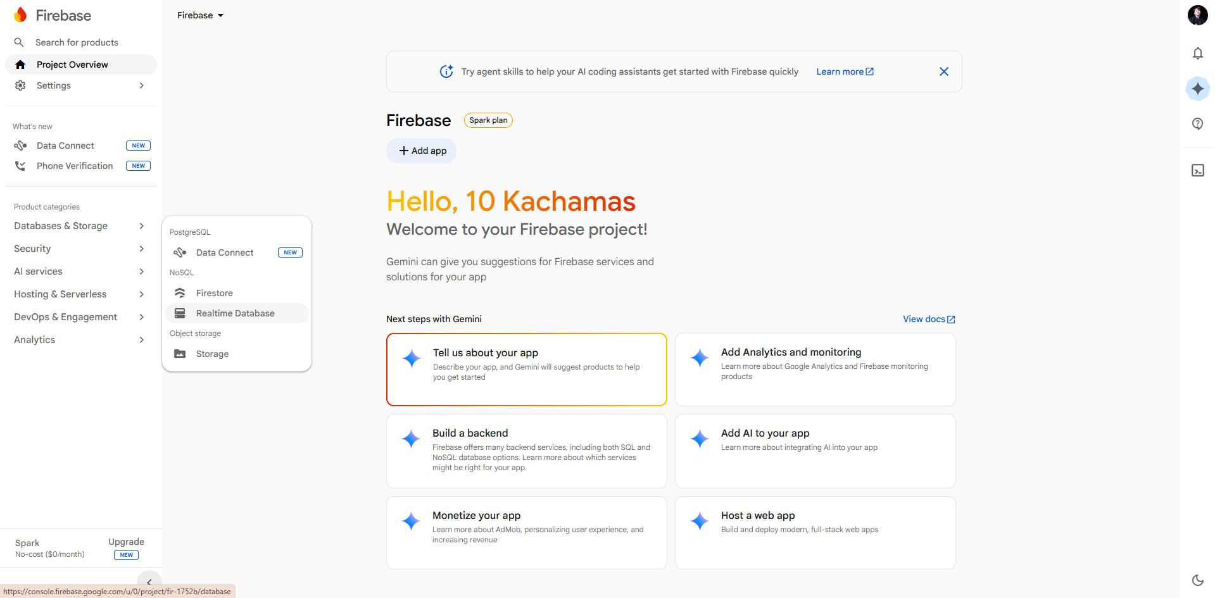
[picture p20: figure]

รูปที่ 3 Project ใน Firebase

4. สร้าง Firebase Realtime Database

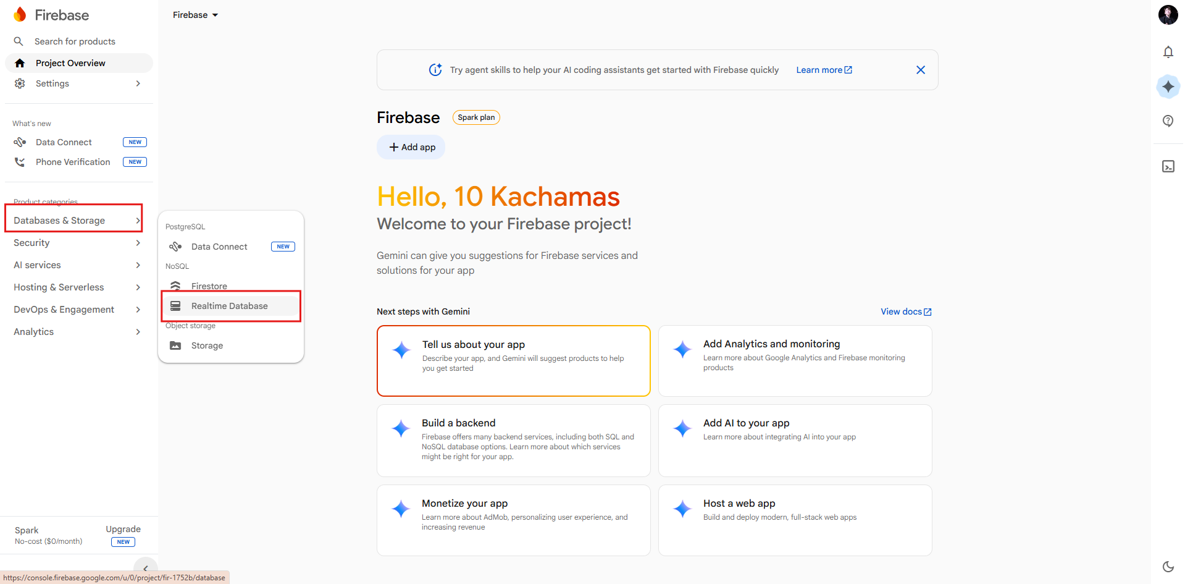
[picture p21: figure]

รูปที่ 4 การสร้าง Realtime Database

5. กด create database

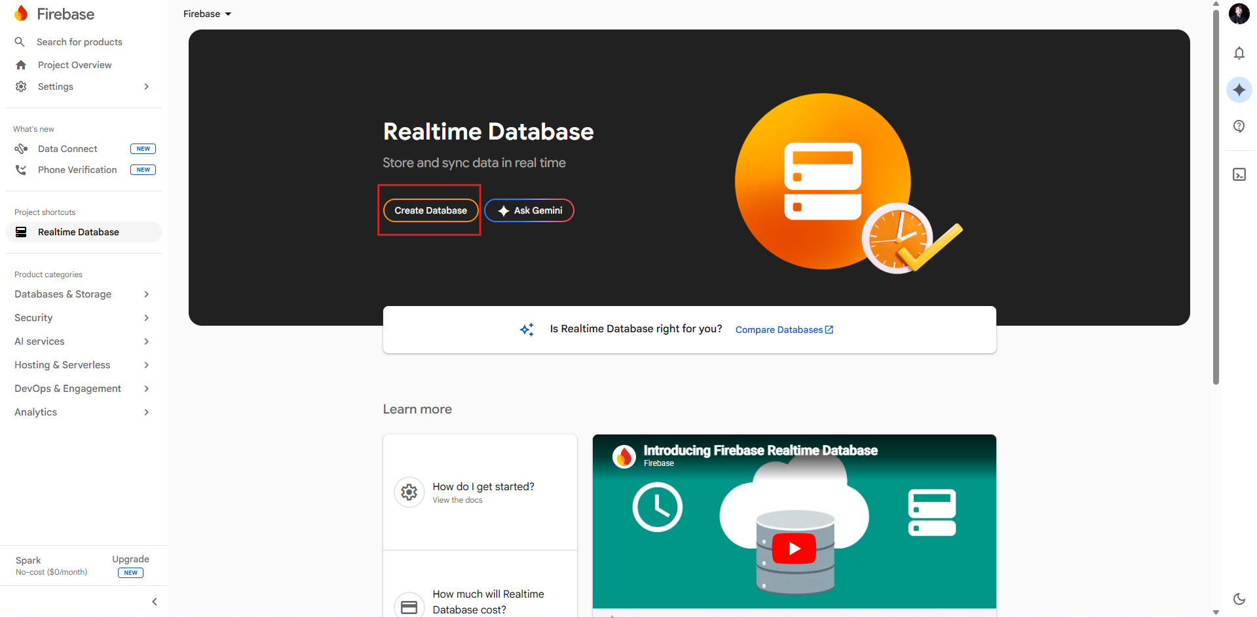
[picture p22: figure]

รูปที่ 5 สร้าง Realtime Database

6. Set up database เลือก Realtime database location เป็น Singapore

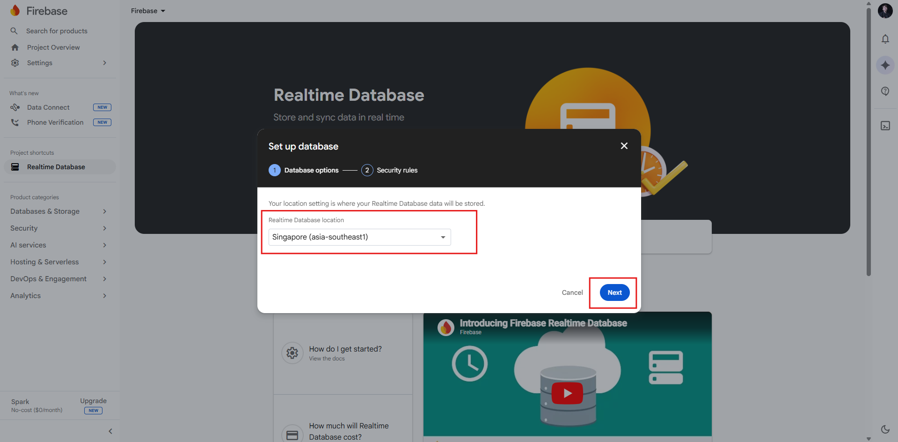
[picture p23: figure]

รูปที่ 6 Set up database

7. Security Rules เลือกเป็น Test mode เพื่อที่เราจะสามารถส่งข้อมูลจากบอร์ดขึ้น Firebase ได้ และกด Enable

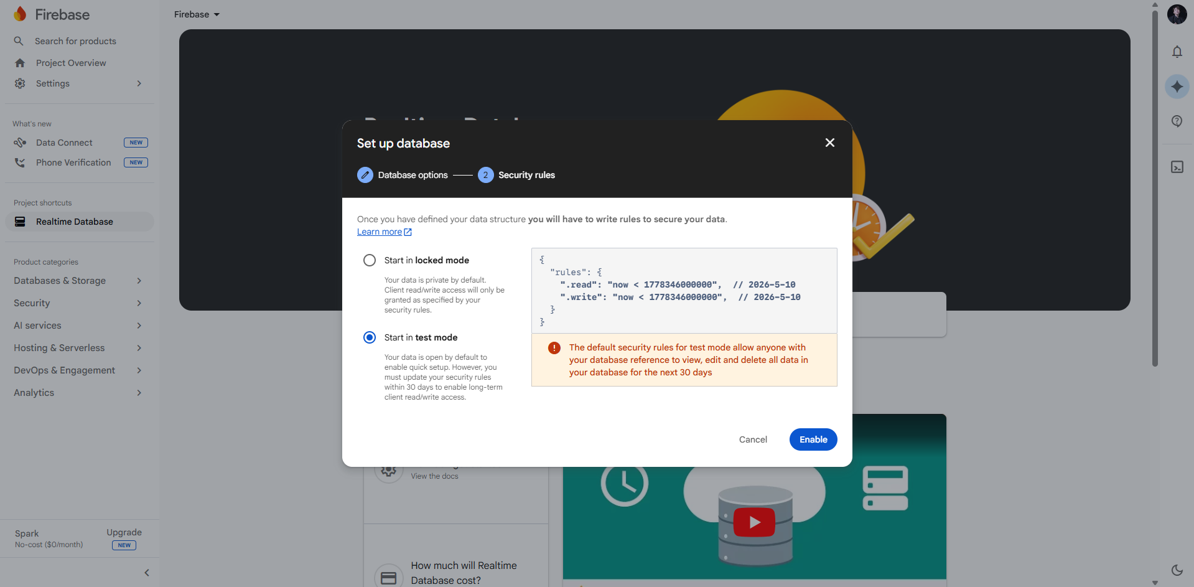
[picture p24: figure]

รูปที่ 7 Security Rules

8. สร้าง Firebase Realtime Database สำเร็จ แล้วจะได้ลิ้ง URL ไปใส่ในโค้ดเพื่อส่งข้อมูลมาที่ Firebase

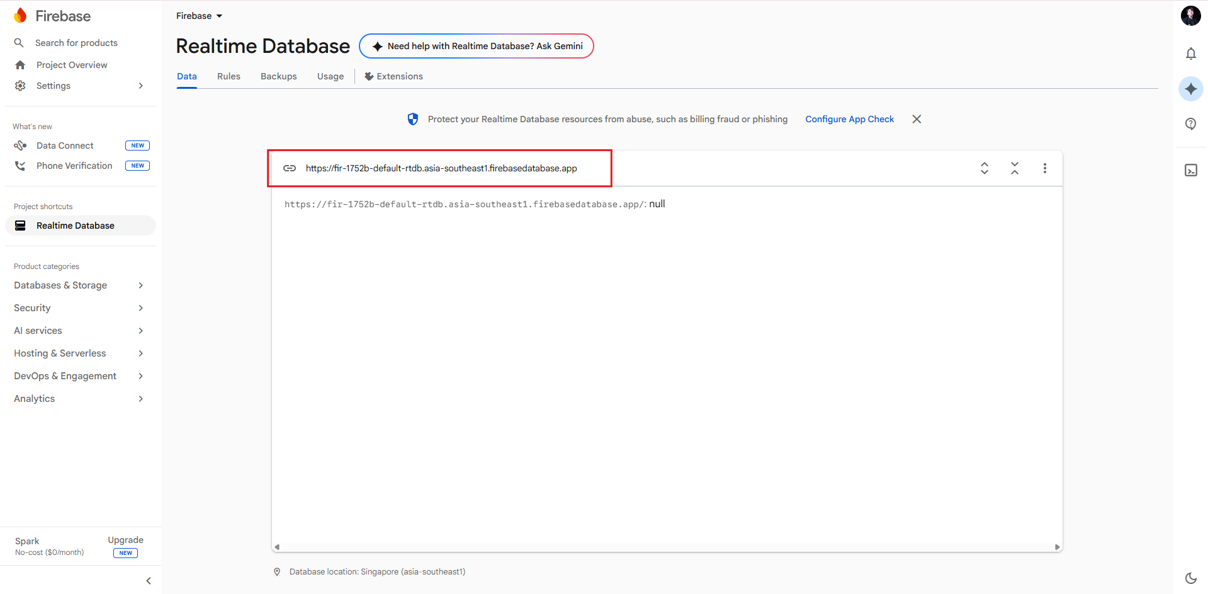
[picture p25: figure]

รูปที่ 8 ลิ้ง URL Realtime Database

9. เนื่องจากเราต้องใช้ API ด้วย ให้ไปที่ Settings → General

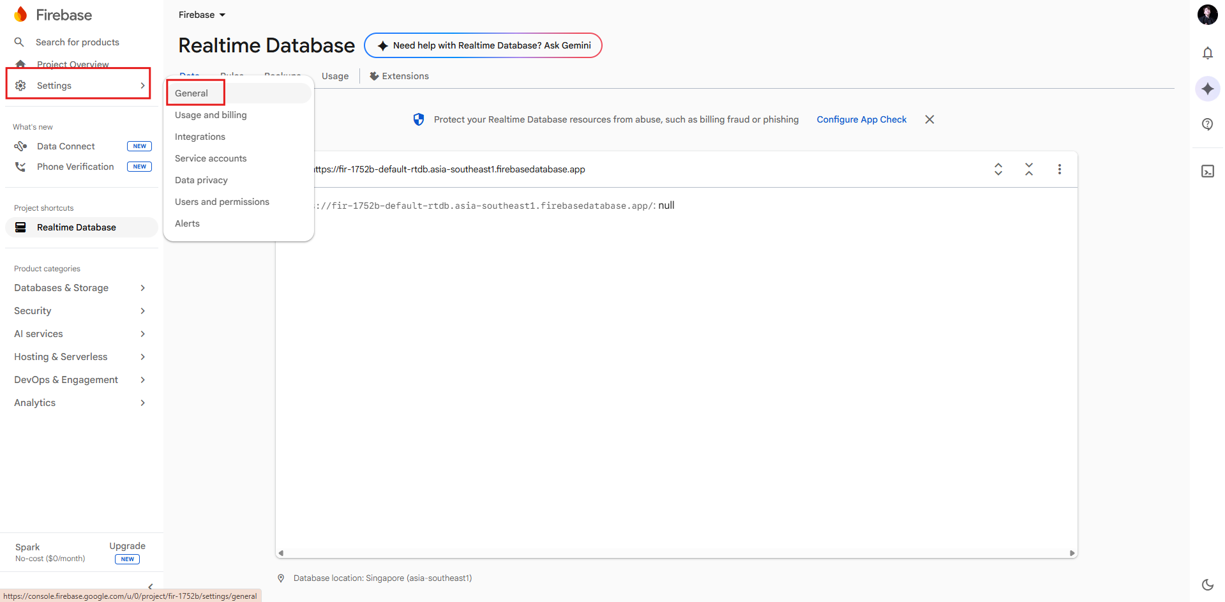
[picture p26: figure]

รูปที่ 9 สร้าง API

10. กดเลือก webapp

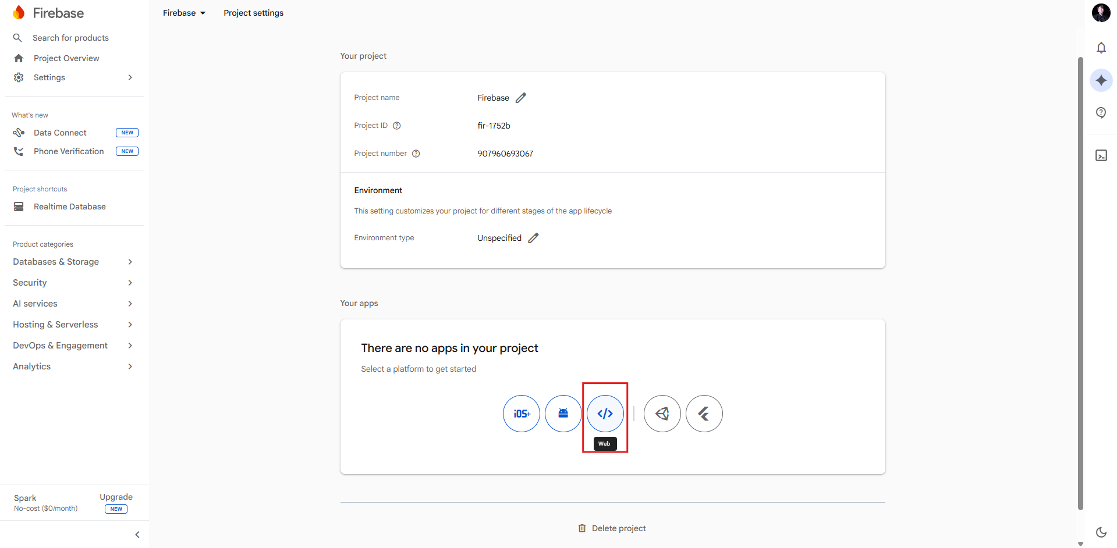
[picture p27: figure]

รูปที่ 10 webapp

11. ตั้งชื่อและกด registor

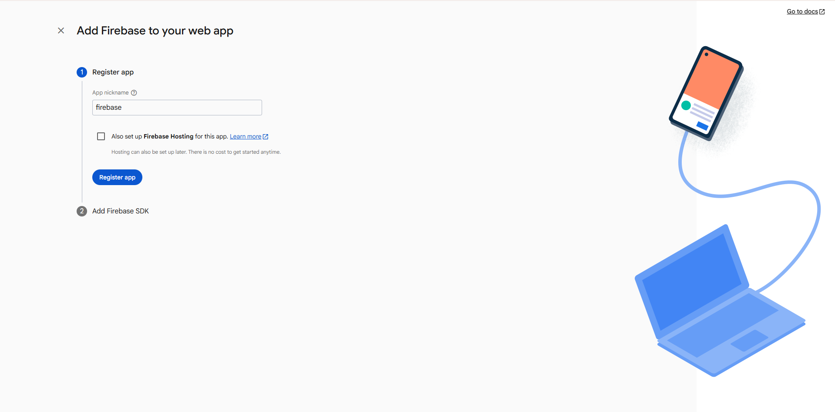
[picture p28: figure]

รูปที่ 11 ตั้งชื่อ webapp

12. ขึ้นแบบนี้ให้กด Continue to console

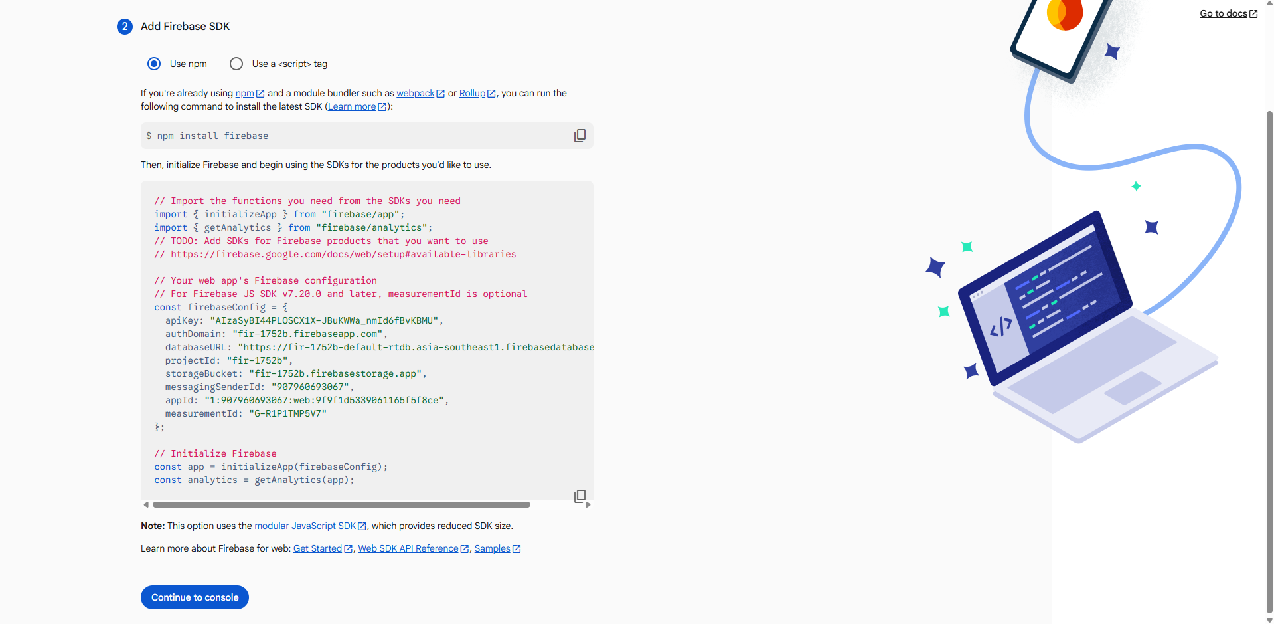
[picture p29: figure]

รูปที่ 12 API

13. เมื่อเราทำเสร็จเราก็จะได้ API ของ Firebase

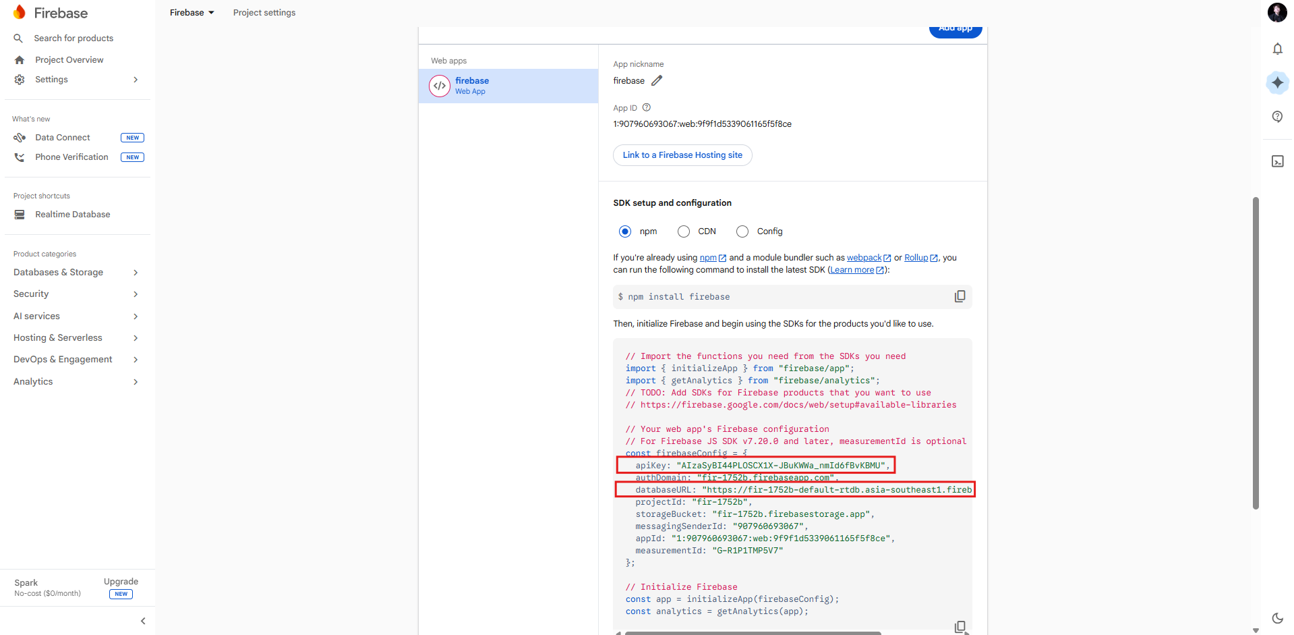
[picture p30: figure]

รูปที่ 13 API Firebase
