bibibi0201/FinalProject/data_user/User_Results.xlsx

Sheet: Form Responses 1
Timestamp | เพศสภาพร่างกาย | อายุ | ส่วนสูง (cm.) ตัวอย่าง 170 | น้ำหนัก (Kg.) ตัวอย่าง 70 | ค่าองศาเริ่มต้นที่วัด Pitch และ Roll ของท่าน ตัวอย่าง p(pitch) = x.xx , r(Roll) = x.xx | โดยปกติคุณนั่งทำงาน/เรียนหน้าคอมพิวเตอร์เฉลี่ยวันละกี่ชั่วโมง? | คุณมีอาการปวดหลัง คอ บ่า ไหล่ (Office Syndrome) เป็นประจำหรือไม่? | ท่านยินยอมให้เก็บรวบรวมและใช้ข้อมูลส่วนบุคคลของท่านหรือไม่? | ด้านที่ 1 : อุปกรณ์ฮาร์ดแวร์ (Hardware & Sensor) [ขนาดและน้ำหนักของอุปกรณ์มีความกะทัดรัด ไม่เกะกะ] | ด้านที่ 1 : อุปกรณ์ฮาร์ดแวร์ (Hardware & Sensor) [อุปกรณ์สามารถสวมใส่ หรือติดตั้งใช้งานได้ง่าย ไม่ซับซ้อน] | ด้านที่ 1 : อุปกรณ์ฮาร์ดแวร์ (Hardware & Sensor) [ความรู้สึกสบายเมื่อต้องใช้งานอุปกรณ์ติดต่อกันเป็นเวลานาน] | ด้านที่ 1 : อุปกรณ์ฮาร์ดแวร์ (Hardware & Sensor) [อุปกรณ์ไม่ก่อให้เกิดความร้อนจนรบกวนการใช้งาน] | ด้านที่ 1 : อุปกรณ์ฮาร์ดแวร์ (Hardware & Sensor) [ความทนทานและรูปแบบการจัดเก็บสายไฟ/ตัวบอร์ด ดูปลอดภัยและเรียบร้อย] | ด้านที่ 2: แอปพลิเคชันและการแสดงผล (Software & User Interface) [การออกแบบหน้าจอแอปพลิเคชัน (UI) มีความสวยงาม ทันสมัย] | ด้านที่ 2: แอปพลิเคชันและการแสดงผล (Software & User Interface) [ความรวดเร็วของการคำนวณและแสดงผลคะแนนรวมของการนั่ง] | ด้านที่ 2: แอปพลิเคชันและการแสดงผล (Software & User Interface) [หน้าแสดงประวัติ (History) และการสรุปข้อมูล เข้าใจง่าย ช่วยให้ท่านเห็นแนวโน้มพฤติกรรมของตนเองได้ชัดเจน] | ด้านที่ 2: แอปพลิเคชันและการแสดงผล (Software & User Interface) [ข้อความคำแนะนำ (Advice) มีความเหมาะสม เข้าใจง่าย และน่าสนใจ] | ด้านที่ 2: แอปพลิเคชันและการแสดงผล (Software & User Interface) [ระดับภาษาที่ระบบใช้แจ้งเตือน (ชมเชย, แนะนำ, ตักเตือน) ช่วยสร้างแรงจูงใจได้ดี] | ด้านที่ 3: ประโยชน์ต่อสุขภาพและการนำไปใช้งานจริง (Health Impact & Practicality) [ระบบนี้ช่วยให้คุณตระหนักรู้ (Awareness) ถึงท่านั่งที่ผิดปกติของตนเองได้เร็วขึ้น] | ด้านที่ 3: ประโยชน์ต่อสุขภาพและการนำไปใช้งานจริง (Health Impact & Practicality) [ข้อความแจ้งเตือนช่วยกระตุ้นให้คุณอยากปรับเปลี่ยนท่านั่งให้ถูกต้อง] | ด้านที่ 3: ประโยชน์ต่อสุขภาพและการนำไปใช้งานจริง (Health Impact & Practicality) [หากใช้งานเป็นประจำ คุณเชื่อว่าระบบนี้จะช่วยลดอาการปวดหลัง/ออฟฟิศซินโดรมได้] | ด้านที่ 3: ประโยชน์ต่อสุขภาพและการนำไปใช้งานจริง (Health Impact & Practicality) [ความเหมาะสมของระบบนี้ในการนำไปใช้จริงในชีวิตประจำวัน (เวลาทำงาน/เรียน)] | ด้านที่ 3: ประโยชน์ต่อสุขภาพและการนำไปใช้งานจริง (Health Impact & Practicality) [ความพึงพอใจในภาพรวม] | ข้อเสนอแนะ และปรับปรุง
2026-03-13 14:31 | หญิง | 18-29 ปี | 150 | 80 | p=55.60, r=-3.14 | มากกว่า 8 ชั่วโมง | มี | ยินยอม | ดีเยี่ยม | ปานกลาง | ดี | ดีเยี่ยม | ดีเยี่ยม | ดี | ดี | ดี | ดี | ดีเยี่ยม | ดี | ดีเยี่ยม | ดี | ดี | ดี | อุปกรณ์ใส่ยาก ตัวแอปตอนเริ่มต้นไม่รู้ว่าต้องกดตรงไหนก่อน
2026-03-13 15:14 | ชาย | 18-29 ปี | 167 | 70 | P=69.00.r=-0.79 | 4 - 8 ชั่วโมง | เป็นบางครั้งบางคราว | ยินยอม | ดีเยี่ยม | ดี | ดีเยี่ยม | ดีเยี่ยม | ดีเยี่ยม | ดี | ดีเยี่ยม | ดีเยี่ยม | ดีเยี่ยม | ดีเยี่ยม | ดี | ดี | ดีเยี่ยม | ดีเยี่ยม | ดี | ใส่ยาก
2026-03-13 16:15 | หญิง | 18-29 ปี | 160 | 100 | P=65.10, R=1.08 | มากกว่า 8 ชั่วโมง | มี | ยินยอม | ดี | ดี | ปานกลาง | ดีเยี่ยม | ดีเยี่ยม | ดีเยี่ยม | ดี | ดี | ดีเยี่ยม | ดีเยี่ยม | ดี | ดีเยี่ยม | ดีเยี่ยม | ดี | ดีเยี่ยม | อาจจะไม่เหมาะกับคนอ้วนเพราะมันทำให้เจ็บช่วงท้อง อาจจะใส่ยากสำหรับช่วงแรก
2026-03-13 19:46 | หญิง | 45-59 ปี | 150 | 48 | P=62.28,R=0.22 | 4 - 8 ชั่วโมง | เป็นบางครั้งบางคราว | ยินยอม | ดี | ดี | ปานกลาง | ปานกลาง | ปานกลาง | ดี | ดี | ดี | ดี | ดี | ดีเยี่ยม | ดีเยี่ยม | ดีเยี่ยม | ดีเยี่ยม | ดีเยี่ยม | อุปกรณ์ควรใช้ระบบเชื่อมต่อแบบไร้สาย การใส่ควรให้สะดวกกว่านี้
2026-03-14 19:21 | ชาย | 45-59 ปี | 160 | 80 | P=61.12,R=0.69 | 4 - 8 ชั่วโมง | เป็นบางครั้งบางคราว | ยินยอม | ดีเยี่ยม | ดีเยี่ยม | ดี | ดีเยี่ยม | ดีเยี่ยม | ดีเยี่ยม | ดีเยี่ยม | ดีเยี่ยม | ดีเยี่ยม | ดีเยี่ยม | ดีเยี่ยม | ดีเยี่ยม | ดีเยี่ยม | ดีเยี่ยม | ดีเยี่ยม
2026-03-14 20:10 | หญิง | 45-59 ปี | 160 | 110 | P=57.23,R=-1.90 | น้อยกว่า 4 ชั่วโมง | ไม่มี | ยินยอม | ดีเยี่ยม | ดี | ดี | ดีเยี่ยม | ดี | ดี | ดีเยี่ยม | ดีเยี่ยม | ดี | ดีเยี่ยม | ดี | ดีเยี่ยม | ดีเยี่ยม | ดีเยี่ยม | ดีเยี่ยม | ไม่มีข้อเสนอแนะ
2026-03-14 20:21 | ชาย | 60 ปีขึ้นไป | 165 | 48 | p=75.62, r=0.86 | น้อยกว่า 4 ชั่วโมง | ไม่มี | ยินยอม | ดีเยี่ยม | ปานกลาง | ดี | ดีเยี่ยม | ดีเยี่ยม | ดีเยี่ยม | ดีเยี่ยม | ดีเยี่ยม | ดี | ดี | ดีเยี่ยม | ดี | ดีเยี่ยม | ดีเยี่ยม | ดีเยี่ยม
2026-03-14 20:31 | หญิง | 18-29 ปี | 150 | 60 | p=51.72, r=-0.50 | มากกว่า 8 ชั่วโมง | มี | ยินยอม | ดีเยี่ยม | ดี | ดีเยี่ยม | ดีเยี่ยม | ดีเยี่ยม | ดีเยี่ยม | ดีเยี่ยม | ดีเยี่ยม | ดี | ดี | ดีเยี่ยม | ดีเยี่ยม | ดีเยี่ยม | ดี | ดีเยี่ยม
2026-03-19 21:44 | หญิง | 18-29 ปี | 165 | 54 | p(pitch)=54.98, r(Roll)=-4.29 | 4 - 8 ชั่วโมง | เป็นบางครั้งบางคราว | ยินยอม | ดี | ดี | ดี | ดีเยี่ยม | ดีเยี่ยม | ดีเยี่ยม | ดีเยี่ยม | ดีเยี่ยม | ดีเยี่ยม | ดีเยี่ยม | ดี | ดีเยี่ยม | ดีเยี่ยม | ดี | ดี | สายไฟค่อนข้างเกะกะ
3/26/2026 0:14:53 | หญิง | 18-29 ปี | 172 | 56 | p = 56.22 , r = 7.62 | 4 - 8 ชั่วโมง | มี | ยินยอม | ดีเยี่ยม | ดี | ดีเยี่ยม | ดีเยี่ยม | ดีเยี่ยม | ดีเยี่ยม | ดีเยี่ยม | ดีเยี่ยม | ดีเยี่ยม | ดีเยี่ยม | ดีเยี่ยม | ดี | ดีเยี่ยม | ดีเยี่ยม | ดีเยี่ยม
3/26/2026 0:16:51 | หญิง | 18-29 ปี | 172 | 56 | p =39.73 ,r = 6.73 | 4 - 8 ชั่วโมง | เป็นบางครั้งบางคราว | ยินยอม | ดีเยี่ยม | ดีเยี่ยม | ดีเยี่ยม | ดีเยี่ยม | ดีเยี่ยม | ดีเยี่ยม | ดีเยี่ยม | ดีเยี่ยม | ดีเยี่ยม | ดีเยี่ยม | ดีเยี่ยม | ดีเยี่ยม | ดีเยี่ยม | ดีเยี่ยม | ดีเยี่ยม
3/26/2026 0:50:10 | หญิง | 18-29 ปี | 165 | 99 | p33.8 r17.67 | 4 - 8 ชั่วโมง | มี | ยินยอม | ดีเยี่ยม | ดีเยี่ยม | ปานกลาง | ดีเยี่ยม | ดี | ดี | ดีเยี่ยม | ดีเยี่ยม | ดี | ดีเยี่ยม | ดีเยี่ยม | ดีเยี่ยม | ดีเยี่ยม | ดีเยี่ยม | ดีเยี่ยม
3/27/2026 1:57:17 | หญิง | 30-44 ปี | 152 | 50 | p=56.31 ,r=-0.98 | มากกว่า 8 ชั่วโมง | มี | ยินยอม | ดี | ดี | ดี | ดีเยี่ยม | ดี | ดี | ดี | ดี | ดี | ดีเยี่ยม | ดี | ดีเยี่ยม | ดี | ปานกลาง | ดี | อุปกรณ์ใส่ยาก
3/27/2026 1:57:58 | หญิง | 18-29 ปี | 151 | 58 | p=52.09, r=-1.28 | มากกว่า 8 ชั่วโมง | มี | ยินยอม | ดีเยี่ยม | ปานกลาง | ดี | ดีเยี่ยม | ดี | ดี | ดีเยี่ยม | ดีเยี่ยม | ดี | ดี | ดีเยี่ยม | ดี | ดี | ดี | ดีเยี่ยม | ใส่ยาก
3/27/2026 2:21:21 | ชาย | 18-29 ปี | 165 | 75 | P=56.73 R0.34 | 4 - 8 ชั่วโมง | เป็นบางครั้งบางคราว | ยินยอม | ดี | ดี | ดีเยี่ยม | ดีเยี่ยม | ดีเยี่ยม | ดี | ดีเยี่ยม | ดีเยี่ยม | ดีเยี่ยม | ดีเยี่ยม | ดี | ดี | ดีเยี่ยม | ดีเยี่ยม | ดีเยี่ยม | ใส่ยากนิดนึง
3/27/2026 11:26:16 | หญิง | 18-29 ปี | 160 | 100 | P=62.65 R=1.46 | 4 - 8 ชั่วโมง | มี | ยินยอม | ดี | ดีเยี่ยม | ดีเยี่ยม | ดีเยี่ยม | ดีเยี่ยม | ดีเยี่ยม | ดีเยี่ยม | ดีเยี่ยม | ดีเยี่ยม | ดีเยี่ยม | ดีเยี่ยม | ดีเยี่ยม | ดีเยี่ยม | ดี | ดีเยี่ยม | -
3/27/2026 14:17:58 | หญิง | 18-29 ปี | 161 | 68 | P(pitch)=27.32788, r(roll)=8.112443 | มากกว่า 8 ชั่วโมง | มี | ยินยอม | ดีเยี่ยม | ดี | ดี | ดีเยี่ยม | ดี | ดี | ดีเยี่ยม | ดีเยี่ยม | ดีเยี่ยม | ดีเยี่ยม | ดีเยี่ยม | ดีเยี่ยม | ดี | ดี | ดี
3/27/2026 14:21:04 | หญิง | 18-29 ปี | 161 | 68 | P(pitch)=51.2497, r(roll)=2.95061 | มากกว่า 8 ชั่วโมง | มี | ยินยอม | ดีเยี่ยม | ดี | ดี | ดีเยี่ยม | ดี | ดี | ดีเยี่ยม | ดีเยี่ยม | ดีเยี่ยม | ดี | ดีเยี่ยม | ดีเยี่ยม | ดี | ดี | ดีเยี่ยม
3/27/2026 19:33:22 | หญิง | 30-44 ปี | 156 | 50 | P=67.94 R=-1.23 | 4 - 8 ชั่วโมง | เป็นบางครั้งบางคราว | ยินยอม | ดี | ดี | ดี | ดี | ดี | ดี | ดี | ดี | ดี | ดี | ดี | ดี | ดี | ดี | ดี
3/27/2026 20:02:41 | ชาย | 30-44 ปี | 160 | 80 | P= 77.85 , R=0.92 | 4 - 8 ชั่วโมง | เป็นบางครั้งบางคราว | ยินยอม | ดีเยี่ยม | ดีเยี่ยม | ดีเยี่ยม | ดีเยี่ยม | ดีเยี่ยม | ดีเยี่ยม | ดีเยี่ยม | ดีเยี่ยม | ดีเยี่ยม | ดีเยี่ยม | ดีเยี่ยม | ดีเยี่ยม | ดีเยี่ยม | ดีเยี่ยม | ดีเยี่ยม
3/30/2026 18:42:24 | หญิง | 18-29 ปี | 169 | 55.5 | 6.2 , 1.69 | มากกว่า 8 ชั่วโมง | มี | ยินยอม | ดีเยี่ยม | ดีเยี่ยม | ดี | ดีเยี่ยม | ดี | ดีเยี่ยม | ปานกลาง | ปานกลาง | ดี | ดีเยี่ยม | ดีเยี่ยม | ดีเยี่ยม | ดีเยี่ยม | ดีเยี่ยม | ดีเยี่ยม
3/30/2026 18:44:51 | หญิง | 18-29 ปี | 169 | 55.5 | 4.4 , 4.03 | มากกว่า 8 ชั่วโมง | มี | ยินยอม | ดีเยี่ยม | ดีเยี่ยม | ดี | ดี | ปานกลาง | ดีเยี่ยม | ดี | ดีเยี่ยม | ดีเยี่ยม | ดีเยี่ยม | ดีเยี่ยม | ดีเยี่ยม | ดีเยี่ยม | ดีเยี่ยม | ดีเยี่ยม
3/30/2026 18:46:59 | หญิง | 18-29 ปี | 169.5 | 52 | 5.78 , 0.01 | มากกว่า 8 ชั่วโมง | มี | ยินยอม | ดีเยี่ยม | ดีเยี่ยม | ดีเยี่ยม | ดีเยี่ยม | ดีเยี่ยม | ดีเยี่ยม | ปานกลาง | ดีเยี่ยม | ดีเยี่ยม | ดีเยี่ยม | ดีเยี่ยม | ดีเยี่ยม | ดีเยี่ยม | ดีเยี่ยม | ดีเยี่ยม
3/30/2026 20:06:49 | หญิง | 18-29 ปี | 165 | 54 | 0,0 | 4 - 8 ชั่วโมง | มี | ยินยอม | ดี | ดี | ปานกลาง | ดีเยี่ยม | ดี | ดีเยี่ยม | ดีเยี่ยม | ดีเยี่ยม | ดีเยี่ยม | ดีเยี่ยม | ดีเยี่ยม | ดีเยี่ยม | ดีเยี่ยม | ดีเยี่ยม | ดี | การใส่ค่อนข้างยาก
3/30/2026 21:14:07 | หญิง | 18-29 ปี | 164 | 55 | 59.7,-2.5 | มากกว่า 8 ชั่วโมง | เป็นบางครั้งบางคราว | ยินยอม | ดี | ดี | ดี | ดี | ดี | ดีเยี่ยม | ดีเยี่ยม | ดีเยี่ยม | ดีเยี่ยม | ดีเยี่ยม | ดี | ดีเยี่ยม | ดีเยี่ยม | ดีเยี่ยม | ดี

Sheet: total
Hardware | ค่ามัธยฐาน | ระดับ | ค่าเฉลี่ย | ระดับ
1. ขนาดและน้ำหนักของอุปกรณ์มีความกะทัดรัด ไม่เกะกะ | 4.0000 | ดี | 4.51-5.00 | ดีเยี่ยม
2. อุปกรณ์สามารถสวมใส่ หรือติดตั้งใช้งานได้ง่าย ไม่ซับซ้อน | 4.0000 | ดี | 3.51-4.50 | ดี
3. ความรู้สึกสบายเมื่อต้องใช้งานอุปกรณ์ติดต่อกันเป็นเวลานาน | 4.0000 | ดี | 2.51-3.50 | ปานกลาง
4. อุปกรณ์ไม่ก่อให้เกิดความร้อนจนรบกวนการใช้งาน | 5.0000 | ดีเยี่ยม | 1.51-2.50 | น้อย
5. ความทนทานและรูปแบบการจัดเก็บสายไฟ/ตัวบอร์ด ดูปลอดภัยและเรียบร้อย | 5.0000 | ดีเยี่ยม | 1.00-1.50 | ปรับปรุง
ค่าเฉลี่ยรวม | 4.0000 | ดี
Application
1. การออกแบบหน้าจอแอปพลิเคชัน (UI) มีความสวยงาม ทันสมัย | 5.0000 | ดีเยี่ยม
2. ความรวดเร็วของการคำนวณและแสดงผลคะแนนรวมของการนั่ง | 5.0000 | ดีเยี่ยม
3. หน้าแสดงประวัติ (History) และการสรุปข้อมูล | 5.0000 | ดีเยี่ยม
4. ข้อความคำแนะนำ (Advice) มีความเหมาะสม เข้าใจง่าย และน่าสนใจ | 5.0000 | ดีเยี่ยม
5. ระดับภาษาที่ระบบใช้แจ้งเตือน (ชมเชย, แนะนำ, ตักเตือน) ช่วยสร้างแรงจูงใจได้ดี | 5.0000 | ดีเยี่ยม
ค่าเฉลี่ยรวม | 5.0000 | ดีเยี่ยม
Health
1. ระบบนี้ช่วยให้คุณตระหนักรู้ (Awareness) ถึงท่านั่งที่ผิดปกติของตนเองได้เร็วขึ้น | 5.0000 | ดีเยี่ยม
2. ข้อความแจ้งเตือนช่วยกระตุ้นให้คุณอยากปรับเปลี่ยนท่านั่งให้ถูกต้อง | 5.0000 | ดีเยี่ยม
3. หากใช้งานเป็นประจำ คุณเชื่อว่าระบบนี้จะช่วยลดอาการปวดหลัง/ออฟฟิศซินโดรมได้ | 5.0000 | ดีเยี่ยม
4. ความเหมาะสมของระบบนี้ในการนำไปใช้จริงในชีวิตประจำวัน (เวลาทำงาน/เรียน) | 5.0000 | ดีเยี่ยม
5. ความพึงพอใจในภาพรวม | 5.0000 | ดีเยี่ยม
ค่ามัธยฐาน | 5.0000 | ดีเยี่ยม

Sheet: Sheet1
หัวข้อผลการประเมิน | ค่ามัธยฐาน | ระดับ
ด้านอุปกรณ์ฮาร์ดแวร์ | 4.0000 | ดี
ด้านแอปพลิเคชันและการแสดงผล | 5.0000 | ดีเยี่ยม
ด้านประโยชน์ต่อสุขภาพและการนำไปใช้งานจริง | 5.0000 | ดีเยี่ยม

Sheet: score1
ข้อที่ | จำนวนคน | คะแนน | ข้อที่ | จำนวนคน | คะแนน | ข้อที่ | จำนวนคน | คะแนน
1 | คนที่ 1 | 5 | 3 | คนที่ 1 | 4 | 5 | คนที่ 1 | 5
 | คนที่ 2 | 4 |  | คนที่ 2 | 5 |  | คนที่ 2 | 5
 | คนที่ 3 | 4 |  | คนที่ 3 | 3 |  | คนที่ 3 | 5
 | คนที่ 4 | 4 |  | คนที่ 4 | 3 |  | คนที่ 4 | 3
 | คนที่ 5 | 5 |  | คนที่ 5 | 4 |  | คนที่ 5 | 5
 | คนที่ 6 | 4 |  | คนที่ 6 | 4 |  | คนที่ 6 | 4
 | คนที่ 7 | 3 |  | คนที่ 7 | 4 |  | คนที่ 7 | 5
 | คนที่ 8 | 4 |  | คนที่ 8 | 5 |  | คนที่ 8 | 5
 | คนที่ 9 | 4 |  | คนที่ 9 | 4 |  | คนที่ 9 | 5
 | คนที่ 10 | 4 |  | คนที่ 10 | 5 |  | คนที่ 10 | 5
 | คนที่ 11 | 5 |  | คนที่ 11 | 5 |  | คนที่ 11 | 5
 | คนที่ 12 | 5 |  | คนที่ 12 | 3 |  | คนที่ 12 | 4
 | คนที่ 13 | 4 |  | คนที่ 13 | 4 |  | คนที่ 13 | 4
 | คนที่ 14 | 3 |  | คนที่ 14 | 4 |  | คนที่ 14 | 4
 | คนที่ 15 | 4 |  | คนที่ 15 | 5 |  | คนที่ 15 | 5
 | คนที่ 16 | 5 |  | คนที่ 16 | 5 |  | คนที่ 16 | 5
 | คนที่ 17 | 4 |  | คนที่ 17 | 4 |  | คนที่ 17 | 4
 | คนที่ 18 | 4 |  | คนที่ 18 | 4 |  | คนที่ 18 | 4
 | คนที่ 19 | 4 |  | คนที่ 19 | 4 |  | คนที่ 19 | 4
 | คนที่ 20 | 5 |  | คนที่ 20 | 5 |  | คนที่ 20 | 5
 | คนที่ 21 | 5 |  | คนที่ 21 | 4 |  | คนที่ 21 | 4
 | คนที่ 22 | 5 |  | คนที่ 22 | 4 |  | คนที่ 22 | 3
 | คนที่ 23 | 5 |  | คนที่ 23 | 5 |  | คนที่ 23 | 5
 | คนที่ 24 | 4 |  | คนที่ 24 | 3 |  | คนที่ 24 | 4
 | คนที่ 25 | 4 |  | คนที่ 25 | 4 |  | คนที่ 25 | 4
ค่าเฉลี่ย |  | 4.0000 | ค่าเฉลี่ย |  | 4.0000 | ค่าเฉลี่ย |  | 5.0000
2 | คนที่ 1 | 3 | 4 | คนที่ 1 | 5
 | คนที่ 2 | 4 |  | คนที่ 2 | 5
 | คนที่ 3 | 4 |  | คนที่ 3 | 5
 | คนที่ 4 | 4 |  | คนที่ 4 | 3
 | คนที่ 5 | 5 |  | คนที่ 5 | 5
 | คนที่ 6 | 4 |  | คนที่ 6 | 5
 | คนที่ 7 | 3 |  | คนที่ 7 | 5
 | คนที่ 8 | 4 |  | คนที่ 8 | 5
 | คนที่ 9 | 4 |  | คนที่ 9 | 5
 | คนที่ 10 | 4 |  | คนที่ 10 | 5
 | คนที่ 11 | 5 |  | คนที่ 11 | 5
 | คนที่ 12 | 5 |  | คนที่ 12 | 5
 | คนที่ 13 | 4 |  | คนที่ 13 | 5
 | คนที่ 14 | 3 |  | คนที่ 14 | 5
 | คนที่ 15 | 4 |  | คนที่ 15 | 5
 | คนที่ 16 | 5 |  | คนที่ 16 | 5
 | คนที่ 17 | 4 |  | คนที่ 17 | 5
 | คนที่ 18 | 4 |  | คนที่ 18 | 5
 | คนที่ 19 | 4 |  | คนที่ 19 | 4
 | คนที่ 20 | 5 |  | คนที่ 20 | 5
 | คนที่ 21 | 5 |  | คนที่ 21 | 5
 | คนที่ 22 | 5 |  | คนที่ 22 | 4
 | คนที่ 23 | 5 |  | คนที่ 23 | 5
 | คนที่ 24 | 4 |  | คนที่ 24 | 5
 | คนที่ 25 | 4 |  | คนที่ 25 | 4
ค่าเฉลี่ย |  | 4.0000 | ค่าเฉลี่ย |  | 5.0000

Sheet: score2
ข้อที่ | จำนวนคน | คะแนน | ข้อที่ | จำนวนคน | คะแนน | ข้อที่ | จำนวนคน | คะแนน
1 | คนที่ 1 | 4 | 3 | คนที่ 1 | 4 | 5 | คนที่ 1 | 5
 | คนที่ 2 | 4 |  | คนที่ 2 | 5 |  | คนที่ 2 | 5
 | คนที่ 3 | 5 |  | คนที่ 3 | 4 |  | คนที่ 3 | 5
 | คนที่ 4 | 4 |  | คนที่ 4 | 4 |  | คนที่ 4 | 4
 | คนที่ 5 | 5 |  | คนที่ 5 | 5 |  | คนที่ 5 | 5
 | คนที่ 6 | 4 |  | คนที่ 6 | 5 |  | คนที่ 6 | 5
 | คนที่ 7 | 5 |  | คนที่ 7 | 5 |  | คนที่ 7 | 4
 | คนที่ 8 | 5 |  | คนที่ 8 | 5 |  | คนที่ 8 | 4
 | คนที่ 9 | 5 |  | คนที่ 9 | 5 |  | คนที่ 9 | 5
 | คนที่ 10 | 5 |  | คนที่ 10 | 5 |  | คนที่ 10 | 5
 | คนที่ 11 | 5 |  | คนที่ 11 | 5 |  | คนที่ 11 | 5
 | คนที่ 12 | 4 |  | คนที่ 12 | 5 |  | คนที่ 12 | 5
 | คนที่ 13 | 4 |  | คนที่ 13 | 4 |  | คนที่ 13 | 5
 | คนที่ 14 | 4 |  | คนที่ 14 | 5 |  | คนที่ 14 | 4
 | คนที่ 15 | 4 |  | คนที่ 15 | 5 |  | คนที่ 15 | 5
 | คนที่ 16 | 5 |  | คนที่ 16 | 5 |  | คนที่ 16 | 5
 | คนที่ 17 | 4 |  | คนที่ 17 | 5 |  | คนที่ 17 | 5
 | คนที่ 18 | 4 |  | คนที่ 18 | 5 |  | คนที่ 18 | 4
 | คนที่ 19 | 4 |  | คนที่ 19 | 4 |  | คนที่ 19 | 4
 | คนที่ 20 | 5 |  | คนที่ 20 | 5 |  | คนที่ 20 | 5
 | คนที่ 21 | 5 |  | คนที่ 21 | 3 |  | คนที่ 21 | 5
 | คนที่ 22 | 5 |  | คนที่ 22 | 5 |  | คนที่ 22 | 5
 | คนที่ 23 | 5 |  | คนที่ 23 | 5 |  | คนที่ 23 | 5
 | คนที่ 24 | 5 |  | คนที่ 24 | 5 |  | คนที่ 24 | 5
 | คนที่ 25 | 5 |  | คนที่ 25 | 5 |  | คนที่ 25 | 5
ค่าเฉลี่ย |  | 5 | ค่าเฉลี่ย |  | 5 | ค่าเฉลี่ย |  | 5
2 | คนที่ 1 | 4 | 4 | คนที่ 1 | 4
 | คนที่ 2 | 5 |  | คนที่ 2 | 5
 | คนที่ 3 | 4 |  | คนที่ 3 | 5
 | คนที่ 4 | 4 |  | คนที่ 4 | 4
 | คนที่ 5 | 5 |  | คนที่ 5 | 5
 | คนที่ 6 | 5 |  | คนที่ 6 | 4
 | คนที่ 7 | 5 |  | คนที่ 7 | 4
 | คนที่ 8 | 5 |  | คนที่ 8 | 4
 | คนที่ 9 | 5 |  | คนที่ 9 | 5
 | คนที่ 10 | 5 |  | คนที่ 10 | 5
 | คนที่ 11 | 5 |  | คนที่ 11 | 5
 | คนที่ 12 | 5 |  | คนที่ 12 | 4
 | คนที่ 13 | 4 |  | คนที่ 13 | 4
 | คนที่ 14 | 5 |  | คนที่ 14 | 4
 | คนที่ 15 | 5 |  | คนที่ 15 | 5
 | คนที่ 16 | 5 |  | คนที่ 16 | 5
 | คนที่ 17 | 5 |  | คนที่ 17 | 5
 | คนที่ 18 | 5 |  | คนที่ 18 | 5
 | คนที่ 19 | 4 |  | คนที่ 19 | 4
 | คนที่ 20 | 5 |  | คนที่ 20 | 5
 | คนที่ 21 | 3 |  | คนที่ 21 | 4
 | คนที่ 22 | 4 |  | คนที่ 22 | 5
 | คนที่ 23 | 3 |  | คนที่ 23 | 5
 | คนที่ 24 | 5 |  | คนที่ 24 | 5
 | คนที่ 25 | 5 |  | คนที่ 25 | 5
ค่าเฉลี่ย |  | 5 | ค่าเฉลี่ย |  | 5

Sheet: score3
ข้อที่ | จำนวนคน | คะแนน | ข้อที่ | จำนวนคน | คะแนน | ข้อที่ | จำนวนคน | คะแนน
1 | คนที่ 1 | 4 | 3 | คนที่ 1 | 4 | 5 | คนที่ 1 | 4
 | คนที่ 2 | 4 |  | คนที่ 2 | 5 |  | คนที่ 2 | 4
 | คนที่ 3 | 4 |  | คนที่ 3 | 5 |  | คนที่ 3 | 5
 | คนที่ 4 | 5 |  | คนที่ 4 | 5 |  | คนที่ 4 | 5
 | คนที่ 5 | 5 |  | คนที่ 5 | 5 |  | คนที่ 5 | 5
 | คนที่ 6 | 4 |  | คนที่ 6 | 5 |  | คนที่ 6 | 5
 | คนที่ 7 | 5 |  | คนที่ 7 | 5 |  | คนที่ 7 | 5
 | คนที่ 8 | 5 |  | คนที่ 8 | 5 |  | คนที่ 8 | 5
 | คนที่ 9 | 4 |  | คนที่ 9 | 5 |  | คนที่ 9 | 4
 | คนที่ 10 | 5 |  | คนที่ 10 | 5 |  | คนที่ 10 | 5
 | คนที่ 11 | 5 |  | คนที่ 11 | 5 |  | คนที่ 11 | 5
 | คนที่ 12 | 5 |  | คนที่ 12 | 5 |  | คนที่ 12 | 5
 | คนที่ 13 | 4 |  | คนที่ 13 | 4 |  | คนที่ 13 | 4
 | คนที่ 14 | 5 |  | คนที่ 14 | 4 |  | คนที่ 14 | 5
 | คนที่ 15 | 4 |  | คนที่ 15 | 5 |  | คนที่ 15 | 5
 | คนที่ 16 | 5 |  | คนที่ 16 | 5 |  | คนที่ 16 | 5
 | คนที่ 17 | 5 |  | คนที่ 17 | 4 |  | คนที่ 17 | 4
 | คนที่ 18 | 5 |  | คนที่ 18 | 4 |  | คนที่ 18 | 5
 | คนที่ 19 | 4 |  | คนที่ 19 | 4 |  | คนที่ 19 | 4
 | คนที่ 20 | 5 |  | คนที่ 20 | 5 |  | คนที่ 20 | 5
 | คนที่ 21 | 5 |  | คนที่ 21 | 5 |  | คนที่ 21 | 5
 | คนที่ 22 | 5 |  | คนที่ 22 | 5 |  | คนที่ 22 | 5
 | คนที่ 23 | 5 |  | คนที่ 23 | 5 |  | คนที่ 23 | 5
 | คนที่ 24 | 5 |  | คนที่ 24 | 5 |  | คนที่ 24 | 4
 | คนที่ 25 | 4 |  | คนที่ 25 | 5 |  | คนที่ 25 | 4
ค่าเฉลี่ย |  | 5 | ค่าเฉลี่ย |  | 5 | ค่าเฉลี่ย |  | 5
2 | คนที่ 1 | 5 | 4 | คนที่ 1 | 4
 | คนที่ 2 | 4 |  | คนที่ 2 | 5
 | คนที่ 3 | 5 |  | คนที่ 3 | 4
 | คนที่ 4 | 5 |  | คนที่ 4 | 5
 | คนที่ 5 | 5 |  | คนที่ 5 | 5
 | คนที่ 6 | 5 |  | คนที่ 6 | 5
 | คนที่ 7 | 4 |  | คนที่ 7 | 5
 | คนที่ 8 | 5 |  | คนที่ 8 | 4
 | คนที่ 9 | 5 |  | คนที่ 9 | 4
 | คนที่ 10 | 4 |  | คนที่ 10 | 5
 | คนที่ 11 | 5 |  | คนที่ 11 | 5
 | คนที่ 12 | 5 |  | คนที่ 12 | 5
 | คนที่ 13 | 5 |  | คนที่ 13 | 3
 | คนที่ 14 | 4 |  | คนที่ 14 | 4
 | คนที่ 15 | 4 |  | คนที่ 15 | 5
 | คนที่ 16 | 5 |  | คนที่ 16 | 4
 | คนที่ 17 | 5 |  | คนที่ 17 | 4
 | คนที่ 18 | 5 |  | คนที่ 18 | 4
 | คนที่ 19 | 4 |  | คนที่ 19 | 4
 | คนที่ 20 | 5 |  | คนที่ 20 | 5
 | คนที่ 21 | 5 |  | คนที่ 21 | 5
 | คนที่ 22 | 5 |  | คนที่ 22 | 5
 | คนที่ 23 | 5 |  | คนที่ 23 | 5
 | คนที่ 24 | 5 |  | คนที่ 24 | 5
 | คนที่ 25 | 5 |  | คนที่ 25 | 5
ค่าเฉลี่ย |  | 5 | ค่าเฉลี่ย |  | 5
