bibibi0201/FinalProject/Report/Flowchart/esp32_flowchart.drawio.pdf

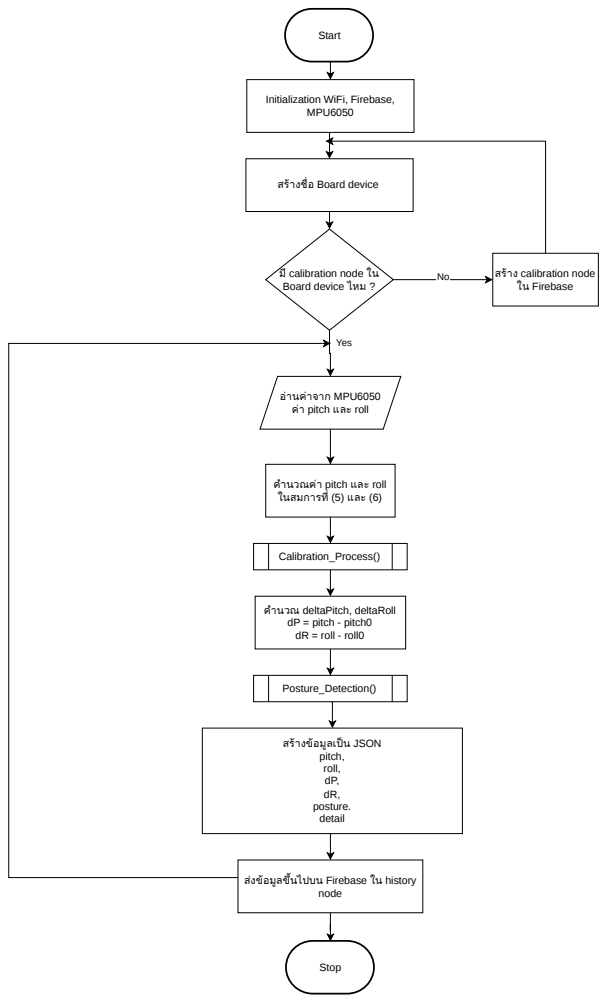
[picture p31: page 1]
MPU6050; Yes; ในสมการที่; (5) และ (6); Calibration_Process(); Posture_Detection(); pitch, roll, dP, dR, posture. detail; ส่งข้อมูลขึ้นไปบน ขึ้; Firebase ใน history; node; Start; Stop

Initialization WiFi, Firebase,

สร้างชื่อ Board device

มี calibration node ใน
Board device ไหม ?

สร้าง calibration node
ใน Firebase

อ่านค่าจาก MPU6050
ค่า pitch และ roll

คำนวณค่า pitch และ roll

คำนวณ deltaPitch, deltaRoll
dP = pitch - pitch0
dR = roll - roll0

สร้างข้อมูลเป็น JSON

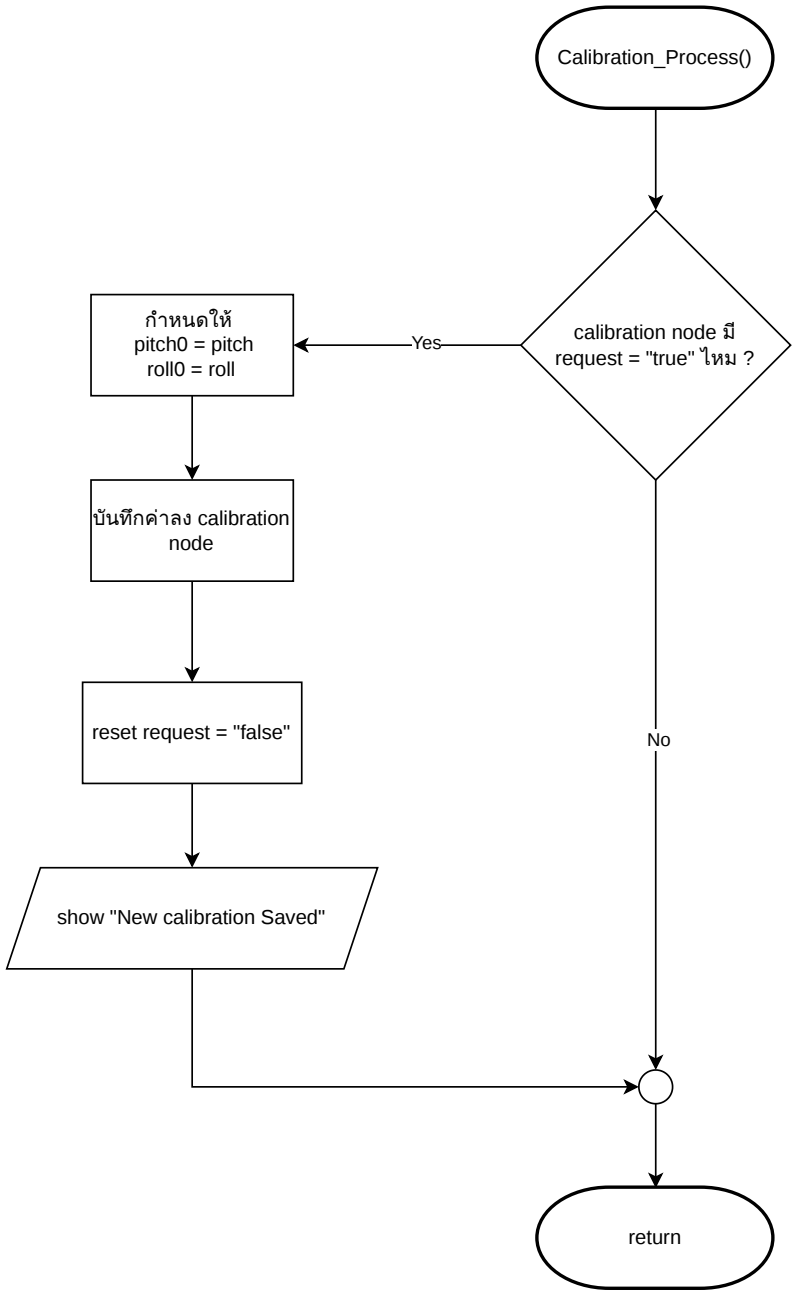
[picture p32: figure]
Yes; calibration node มี request = "true" ไหม ?; กำหนดให้ pitch0 = pitch roll0 = roll; บันทึกค่าลง calibration node; show "New calibration Saved"; reset request = "false"; Calibration_Process(); return
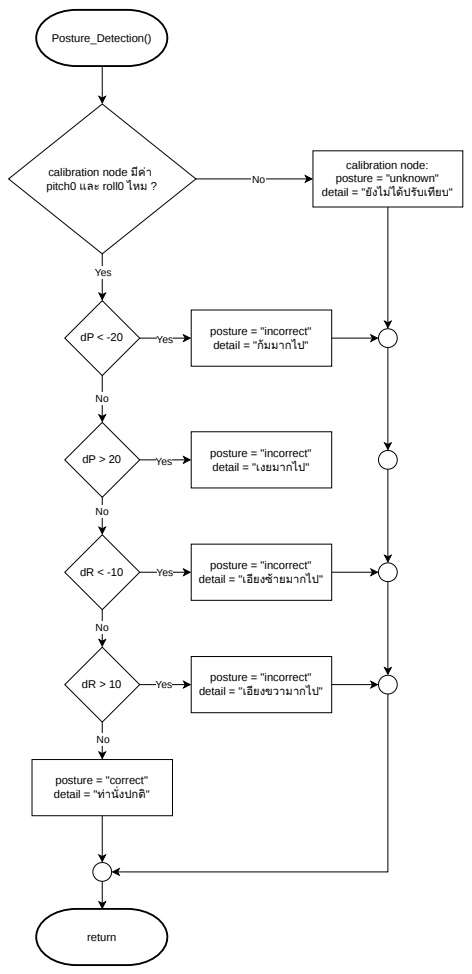
[picture p33: page 3]
calibration node มีค่า pitch0 และ roll0 ไหม ?; posture = "incorrect"; detail = "ก้มมากไป"; detail = "เงยมากไป"; Yes; Posture_Detection(); return

calibration node:
posture = "unknown"
detail = "ยังไม่ได้ปรับเทียบ"

Yes
detail = "เอียงซ้ายมากไป"

detail = "เอียงขวามากไป"

posture = "correct"
detail = "ท่านั่งปกติ"
