bibibi0201/FinalProject/(commit log)

2026-03-08 Add files via upload
    ESP32+MPU6050
2026-03-12 fix posture notification for new device
2026-04-09 Add files via upload
    python คำนวณ paired t-test
